irekzielinski/Pylontech-Battery-Monitoring/(threads)

Thread 1 (2019-10-15):

Response is only ????

TMHEINE, 2019-10-15:
Hi,
I did all the same as you did, with the same elements (Wemos D1 mini, Sparkfun Max3232).
I can access the web interface. But all responses I get is always "????".
What is wrong?
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

djsyl, 2019-12-05:
hello
same thing for me !

TMHEINE, 2019-12-09:
I use now the can Port to read the SOC.
RPI3 with PiCan2

djsyl, 2019-12-12:
Now it work for me
when use a other max3232 not work
with the same of description it's good now

TMHEINE, 2021-04-22:
Hello,

I tried it again all new.
Parts:
Wemos D1 Mini v3.0.0
Sparkfun Max3232 (Bought a new one

I get the same Questionsmarks as before

Mainpage:
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
Power response:
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
The log is:
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

What could be the Problem? Wireing? Arduino?

Compiling Result Arduino:
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

Anyone who can help me?

irekzielinski, 2021-08-05:
@TMHEINE did you get it working?
Your log indicates that ESP is not establising any connection with the battery.
I suspect this is electrical issue/wiring.

TMHEINE, 2021-08-06:
Hello.
Didi not get it working. Electrical/wiring should not be the problem.
Maybe port is not working or something else.
I did not try it again after last test.
For the last test I used a new ESP and new Sparkfun.
I tried lot of different ways likt exchange RX and TX, Other capasitors, different power supplies.
but nothing worked.

So actually i am reading the batteries by can-hat and python.

Wibet10, 2022-02-12:
Hi,
I built one of these monitors a coupe of years ago and  it worked fine with my UC3000 batteries as described in the original design using the RJ11 port. End of last year I fited a new UC3000C battery as master and had to convert to the 8 pin 'Console' port. I rewired the cable and it started working but was erratic. It then refused to read at all and I abandonned it until this month. On investigation, the RS232 signals were barely 8-10volts pk/pk and the MQTT was trying to reconnect every cycle of the program. I also discovered from the web that the UC2000/3000C batteries do not need the 1200/115200 codes and  rate change to wake them, they are ready to communicate at 115200 on startup.
I have commented out 'void wakeUpConsole and void switchBaud' sections of the code and added this into the void loop: -
   void loop() {
  // millis delay check below runs 'mqttLoop' every 30 seconds
      Client.loop();
        if (millis() - lastMillis >= 30*1000UL) // >= 30 sec period
    {
     lastMillis = millis();  // reset ready for next loop
        mqttLoop();
    }
   ArduinoOTA.handle();
  server.handleClient();
  timer.run();_
code from this point is original --
The erratic connection problem was fixed by including a level shifter between the ESP and the MAX3232 as in the attached diagram.
This had the effect of increasing the RS232 signal voltages sent to the battery to around 12/15volts pk/pk, much more in spec and very solid connection.
There seems to have been some changes that accomodate the new battry types since I last checked in (November 2021) and reading the above comments, the discoveries I made in adapting my original build may help resove some of the problems experienced by others.
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
Hope this helps others connecting to UC2000/3000C batteries.

irekzielinski, 2022-02-12:
Thanks - that some good findings!
Do you really need to wrap mqttLoop(); into this 1in30 seconds condition?
There should be no problem calling this every time loop is executed.

Wibet10, 2022-02-12:
Hi, Thanks for the response. I hope the info. on getting a better RS232 connection helps others.
In my original build I tried several MAX3232's before I found a working one. On testing the voltages on my worker during the upgrade, @3.3v the o/p is minimum spec, @5v it is comfortably in spec.
My coding is 'cut and paste' at best! My original problem was the mqtt disconnecting/reconnecting on every loop. In tracing this back to my mqtt user/password set-up, I broke your mqttloop code (probably the syntax somewhere). My crude fix was to put the timing loop into the main loop and only run the mqttloop every 30 secs. My code now compiles and runs ok, think I'll leave it running for a while and look at fixing it later.
Thanks for a great project that has kept up with the battery developments, cheaper than setting up Batteryview and almost as good, nice one!

Wibet10, 2022-02-16:
Sorry you are still having proiblems. I have mine running using the enclosed code, it compiles using Arduino IDE 1.8.13 & 2.0.0rc3 on a Win10 PC. I have a genuine Wemos Mini Pro and a 'cheap generic' Max3232. I started out in February with no reads from the Pylon-stack (Master is now UC3000C - new type) and only ??? when I accessed the local 192.168.1.71 site.
I 'fiddled about' with the code and put in a 'lot of debug comments' to get my head around how it worked, I did get it going but I think I broke some of the original code? My changes are around lines 745-798 and 848-870 in the attached version. There are a lot of serial.prints/notes I have put in to help me remember what I did, hope it helps you sort yours.
DON'T leave any 'extra' Serial.prints in the code or IT WILL totally disrupt the reading of the Pylontech's.
(this is the code as it is working for me now -  copy + paste it into Arduino IDE)
All credit goes to Irek for his original code.

// WiFi code for 'D1 mini Pro' to run Pylontech Console Port into Node Red server on 192.168.1.197
// Has pylontech battery web server access @ 192.168.1.71 (local wifi port)
// Updated 07-02-2022 Taking out start at 1200 and handshake to then switch to 115200 (older batteries) - now starts at 115200 and just reads.

#include <ESP8266WiFi.h>
#include <ESP8266mDNS.h>
#include <ArduinoOTA.h>
#include <ESP8266WebServer.h>
#include <PubSubClient.h>
#include <SimpleTimer.h>
#include <TimeLib.h>        //https://github.com/PaulStoffregen/Time
#include <ntp_time.h>       // this library needs loading manually
#include <circular_log.h>   // this library needs loading manually

//#define DEBUG  // Comment out to remove DEBUG Serial prints - useful to see the loops running
                // if left enabled while connected to pylon - it WILL corrupt the real pylon data reads!!

//IMPORTANT: Specify your WIFI settings:
#define WIFI_SSID "xxxxxxxxxxxxxxxxx"
#define WIFI_PASS "xxxxxxxxxxxxxx"

//IMPORTANT: Uncomment this line if you want to enable MQTT (and fill correct MQTT_ values below):
#define ENABLE_MQTT

#ifdef ENABLE_MQTT
//NOTE 1: if you want to change what is pushed via MQTT - edit function: pushBatteryDataToMqtt. (line 822)
//NOTE 2: MQTT_TOPIC_ROOT is where battery will push MQTT topics. For example "soc" will be pushed to: "pylon_battery/soc"
//Note 3: Using WiFi into Raspberry Pi
#define MQTT_SERVER        "192.168.1.197"  //is Node Red Home Server IP {Home mqtt server 127.0.0.1:1883}
#define MQTT_PORT          1883
#define MQTT_USER          "emonpi"
#define MQTT_PASSWORD      "xxxxxxxxxxxxxx"
#define MQTT_TOPIC_ROOT    "emon/pylon_battery/"  //this is where mqtt data will be pushed
//#define MQTT_PUSH_FREQ_SEC 30  // MQTT push now set by millis delay in 'void loop'
#endif //for #def ENABLE_MQTT

#define ABS_DIFF(a, b) (a > b ? a-b : b-a)

WiFiClient batClient;
PubSubClient Client(batClient);  // set-up MQTT client

char g_szRecvBuff[7000];
static unsigned long g_lastDataSent = 0; //sets initial MQTT last-sent time for first loop
unsigned long lastMillis;

ESP8266WebServer server(80);
SimpleTimer timer;
circular_log<7000> g_log;
bool ntpTimeReceived = false;
int g_baudRate = 0;

void Log(const char* msg)
{
  g_log.Log(msg);
  #ifdef DEBUG
  Serial.println("logging messages");
  #endif
}
//  'callback' Not needed for Pylon??
void callback(char* topic, byte* payload, unsigned int length) {
  Serial.print("Message arrived [");
  Serial.print(topic);
  Serial.print("] ");
  for (int i = 0; i < length; i++) {
    Serial.print((char)payload[i]);
  }
  Serial.println();
}

void reconnect() {
  // loop until we are reconnected
  while (!Client.connected()) {
    Serial.println("Attempting MQTT connection...");
    // Attempt to connect ..
    if (Client.connect("batClient", MQTT_USER, MQTT_PASSWORD ))  {
      Serial.println("connected to MQTT....");
    } else{
      Serial.print("failed. rc= ");
      Serial.println(Client.state());
      Serial.println("Try again in 5 seconds ...");
      delay(5000);
     }
  }
}

void setup_wifi(){
 // We start by connecting to a WiFi network
  WiFi.begin(WIFI_SSID, WIFI_PASS);
  while (WiFi.status() != WL_CONNECTED) {
    delay(500);
    Serial.print(".");
  }
  Serial.println("");
  Serial.println("WiFi connected");
}

void setup() {
   // put your setup code here, to run once:
   Serial.begin(115200);  // new line to start serial at 115200
   #ifdef DEBUG
   Serial.println (".");
   Serial.println ("Set Serial to 115200");
   #endif
    delay(200);
  setup_wifi();
  delay(200);
  #ifdef DEBUG
  Serial.println ("Setting up MQTT server in SETUP ~~~~~~~~~");
  #endif
    Client.setServer(MQTT_SERVER, MQTT_PORT);
    Client.setCallback(callback);    // callback not needed for pylon??

    while (!Client.connected()){
  Serial.println();
  Serial.print("Connecting to ");
  Serial.println(MQTT_SERVER);
  if (Client.connect("batClient", MQTT_USER, MQTT_PASSWORD )) {
    Serial.println(" Connected to MQTT ...");
  } else {
    Serial.print("failed to connect to MQTT with state  ");
    Serial.print(Client.state());
    delay(2000);
      }
    }
  #ifdef DEBUG
  Serial.println("Connected to MQTT .. in setup");
  #endif

  pinMode(LED_BUILTIN, OUTPUT);
  digitalWrite(LED_BUILTIN, HIGH);//high is off

  ArduinoOTA.setHostname("Home_Battery");
  ArduinoOTA.begin();
  server.on("/", handleRoot);
  server.on("/log", handleLog);
  server.on("/req", handleReq);
  server.on("/jsonOut", handleJsonOut);
  server.on("/reboot", [](){
    ESP.restart();
  });

  server.begin();

  syncTime();

  Log("Boot event");
}

void handleLog()
{
  server.send(200, "text/html", g_log.c_str());
}
 /*    This section commented out as old protocol to switch 1200 to 115200 baud
void switchBaud(int newRate)
{
  if(g_baudRate == newRate)
  {
    return;
  }

  if(g_baudRate != 0)
  {
    Serial.flush();
    delay(20);
    Serial.end();
    delay(20);
  }

  char szMsg[50];
  snprintf(szMsg, sizeof(szMsg)-1, "New baud: %d", newRate);
  Log(szMsg);

  Serial.begin(newRate);
  g_baudRate = newRate;
  #ifdef DEBUG
  Serial.println("End of switchBaud loop");
  #endif
  delay(20);
} */

void waitForSerial()
{
  for(int ix=0; ix<150;ix++)
  {
    if(Serial.available()) break;
    delay(10);
  }
  #ifdef DEBUG
  Serial.println("Waiting for serial");
  #endif
}

int readFromSerial()
{
  #ifdef DEBUG
  Serial.println("Starting int-readFromSerial()");
  #endif
  memset(g_szRecvBuff, 0, sizeof(g_szRecvBuff));
  int recvBuffLen = 0;
  bool foundTerminator = true;

  #ifdef DEBUG
  Serial.println("Terminator TRUE");  //#############found true return####################
  #endif

  waitForSerial();

  while(Serial.available())
    {
      #ifdef DEBUG
        Serial.println ("Serial is available");
      #endif

    char szResponse[256] = "";
    const int readNow = Serial.readBytesUntil('>', szResponse, sizeof(szResponse)-1); //all commands terminate with "$$\r\n\rpylon>" (no new line at the end)

    if(readNow > 0 &&
       szResponse[0] != '\0')
    {
      if(readNow + recvBuffLen + 1 >= (int)(sizeof(g_szRecvBuff)))
      {
        Log("WARNING: Read too much data on the console!");
        break;
      }

      strcat(g_szRecvBuff, szResponse);
      recvBuffLen += readNow;

      if(strstr(g_szRecvBuff, "$$\r\n\rpylon"))
      {
        strcat(g_szRecvBuff, ">"); //readBytesUntil will skip this, so re-add
        foundTerminator = true;
        break; //found end of the string
      }

      if(strstr(g_szRecvBuff, "Press [Enter] to be continued,other key to exit"))
      {
        //we need to send new line character so battery continues the output
        Serial.write("\r");
      }

      waitForSerial();
    }
  }

  if(recvBuffLen > 0 )
  {
    if(foundTerminator == false)
    {
      Log("Failed to find pylon> terminator");
    }
  }

  return recvBuffLen;
}

bool readFromSerialAndSendResponse()
{
  const int recvBuffLen = readFromSerial();
  if(recvBuffLen > 0)
  {
    server.sendContent(g_szRecvBuff);
    return true;
  }

  return false;
}

bool sendCommandAndReadSerialResponse(const char* pszCommand)
{
  //switchBaud(115200);  Comented out as do not needed to switch serial for 2000/3000C batteries

  if(pszCommand[0] != '\0')
  {
    Serial.write(pszCommand);
  }
  Serial.write("\n");

  const int recvBuffLen = readFromSerial();
  if(recvBuffLen > 0)
  {
    return true;

    #ifdef DEBUG
    Serial.println("Send Command and Receive Response = True");
    #endif
  }

  //wake up console and try again:
 // wakeUpConsole();  Commented out not needed

  if(pszCommand[0] != '\0')
  {
    Serial.write(pszCommand);
  }
  Serial.write("\n");

  return readFromSerial() > 0;
}

void handleReq()
{
  #ifdef DEBUG
  Serial.println("starting void-handleReq()");
  #endif
  bool respOK;
  if(server.hasArg("code") == false)
  {
    respOK = sendCommandAndReadSerialResponse("");
  }
  else
  {
    respOK = sendCommandAndReadSerialResponse(server.arg("code").c_str());
  }

  if(respOK)
  {
    server.send(200, "text/plain", g_szRecvBuff);
  }
  else
  {
    server.send(500, "text/plain", "????");
  }
}

void handleJsonOut()
{
  #ifdef DEBUG
  Serial.println("Starting void-handleJsonOut");
  #endif
  if(sendCommandAndReadSerialResponse("pwr") == false)
  {
    server.send(500, "text/plain", "Failed to get response to 'pwr' command");
    return;

  }
  parsePwrResponse(g_szRecvBuff);
  prepareJsonOutput(g_szRecvBuff, sizeof(g_szRecvBuff));
  server.send(200, "application/json", g_szRecvBuff);
}

void handleRoot() {
  #ifdef DEBUG
  Serial.println("Starting void-handleRoot");
  #endif
  unsigned long days = 0, hours = 0, minutes = 0;
  unsigned long val = os_getCurrentTimeSec();

  days = val / (3600*24);
  val -= days * (3600*24);

  hours = val / 3600;
  val -= hours * 3600;

  minutes = val / 60;
  val -= minutes*60;

  static char szTmp[2500] = "";
  snprintf(szTmp, sizeof(szTmp)-1, "<html><b>Home_Battery</b><br>Time GMT: %d/%02d/%02d %02d:%02d:%02d (%s)<br>Uptime: %02d:%02d:%02d.%02d<br><br>free heap: %u<br>Wifi RSSI: %d<BR>Wifi SSID: %s",
            year(), month(), day(), hour(), minute(), second(), "GMT",
            (int)days, (int)hours, (int)minutes, (int)val,
            ESP.getFreeHeap(), WiFi.RSSI(), WiFi.SSID().c_str());

  strncat(szTmp, "<BR><a href='/log'>Runtime log</a><HR>", sizeof(szTmp)-1);
  strncat(szTmp, "<form action='/req' method='get'>Command:<input type='text' name='code'/><input type='submit'></form><a href='/req?code=pwr'>Power</a> | <a href='/req?code=help'>Help</a> | <a href='/req?code=log'>Event Log</a> | <a href='/req?code=time'>Time</a>", sizeof(szTmp)-1);
  strncat(szTmp, "</html>", sizeof(szTmp)-1);

  server.send(200, "text/html", szTmp);
}

unsigned long os_getCurrentTimeSec()
{
  static unsigned int wrapCnt = 0;
  static unsigned long lastVal = 0;
  unsigned long currentVal = millis();

  if(currentVal < lastVal)
  {
    wrapCnt++;
  }

  lastVal = currentVal;
  unsigned long seconds = currentVal/1000;

  //millis will wrap each 50 days, as we are interested only in seconds, let's keep the wrap counter
  return (wrapCnt*4294967) + seconds;
}

void syncTime()
{
  //get time from NTP
  time_t currentTimeGMT = getNtpTime();
  if(currentTimeGMT)
  {
    ntpTimeReceived = true;
    setTime(currentTimeGMT);
    #ifdef DEBUG
    Serial.println("NTP Time Synced OK");
    #endif
  }
  else
  {
    timer.setTimeout(5000, syncTime); //try again in 5 seconds
  }
}
/* This section commented out not needed for 2000/3000C batteries
void wakeUpConsole()
{
  switchBaud(1200);

  //byte wakeUpBuff[] = {0x7E, 0x32, 0x30, 0x30, 0x31, 0x34, 0x36, 0x38, 0x32, 0x43, 0x30, 0x30, 0x34, 0x38, 0x35, 0x32, 0x30, 0x46, 0x43, 0x43, 0x33, 0x0D};
  //Serial.write(wakeUpBuff, sizeof(wakeUpBuff));
  Serial.write("~20014682C0048520FCC3\r");
  delay(1000);

  byte newLineBuff[] = {0x0E, 0x0A};
  switchBaud(115200);

  for(int ix=0; ix<10; ix++)
  {
    Serial.write(newLineBuff, sizeof(newLineBuff));
    delay(1000);

    if(Serial.available())
    {
      while(Serial.available())
      {
        Serial.read();
      }

      break;
    }
  }
}  */

#define MAX_PYLON_BATTERIES 4  // was 8

struct pylonBattery
{
  bool isPresent;
  long  soc;     //Coulomb in %
  long  voltage; //in mW
  long  current; //in mA, negative value is discharge
  long  tempr;   //temp of case or BMS?
  long  cellTempLow;
  long  cellTempHigh;
  long  cellVoltLow;
  long  cellVoltHigh;
  char baseState[9];    //Charge | Dischg | Idle
  char voltageState[9]; //Normal
  char currentState[9]; //Normal
  char tempState[9];    //Normal
  char time[20];        //2019-06-08 04:00:29
  char b_v_st[9];       //Normal  (battery voltage?)
  char b_t_st[9];       //Normal  (battery temperature?)

  bool isCharging()    const { return strcmp(baseState, "Charge")   == 0; }
  bool isDischarging() const { return strcmp(baseState, "Dischg")   == 0; }
  bool isIdle()        const { return strcmp(baseState, "Idle")     == 0; }
  bool isBalancing()   const { return strcmp(baseState, "Balance")  == 0; }

  bool isNormal() const
  {
    if(isCharging()    == false &&
       isDischarging() == false &&
       isIdle()        == false &&
       isBalancing()   == false)
    {
      return false; //base state looks wrong!
    }

    return  strcmp(voltageState, "Normal") == 0 &&
            strcmp(currentState, "Normal") == 0 &&
            strcmp(tempState,    "Normal") == 0 &&
            strcmp(b_v_st,       "Normal") == 0 &&
            strcmp(b_t_st,       "Normal") == 0 ;
  }
};

struct batteryStack
{
  int batteryCount;
  int soc;  //in %, if charging: average SOC, otherwise: lowest SOC
  int temp; //in mC, if highest temp is > 15C, this will show the highest temp, otherwise the lowest
  long currentDC;    //mAh current going in or out of the battery
  long avgVoltage;    //in mV
  char baseState[10];  //Charge | Dischg | Idle | Balance | Alarm!

  pylonBattery batts[MAX_PYLON_BATTERIES];

  bool isNormal() const
  {
    for(int ix=0; ix<MAX_PYLON_BATTERIES; ix++)
    {
      if(batts[ix].isPresent &&
         batts[ix].isNormal() == false)
      {
        return false;
      }
    }

    return true;
  }

  //in wH
  long getPowerDC() const
  {
    return (long)(((double)currentDC/1000.0)*((double)avgVoltage/1000.0));
  }

  //wH estimated current on AC side (taking into account Sofar ME3000SP losses)
  long getEstPowerAc() const
  {
    double powerDC = (double)getPowerDC();
    if(powerDC == 0)
    {
      return 0;
    }
    else if(powerDC < 0)
    {
      //we are discharging, on AC side we will see less power due to losses
      if(powerDC < -1000)
      {
        return (long)(powerDC*0.94);
      }
      else if(powerDC < -600)
      {
        return (long)(powerDC*0.90);
      }
      else
      {
        return (long)(powerDC*0.87);
      }
    }
    else
    {
      //we are charging, on AC side we will have more power due to losses
      if(powerDC > 1000)
      {
        return (long)(powerDC*1.06);
      }
      else if(powerDC > 600)
      {
        return (long)(powerDC*1.1);
      }
      else
      {
        return (long)(powerDC*1.13);
      }
    }
  }
};

batteryStack g_stack;

long extractInt(const char* pStr, int pos)
{
  return atol(pStr+pos);
}

void extractStr(const char* pStr, int pos, char* strOut, int strOutSize)
{
  strOut[strOutSize-1] = '\0';
  strncpy(strOut, pStr+pos, strOutSize-1);
  strOutSize--;

  //trim right
  while(strOutSize > 0)
  {
    if(isspace(strOut[strOutSize-1]))
    {
      strOut[strOutSize-1] = '\0';
    }
    else
    {
      break;
    }

    strOutSize--;
  }
}

/* Output has mixed \r and \r\n
pwr

@

Power Volt   Curr   Tempr  Tlow   Thigh  Vlow   Vhigh  Base.St  Volt.St  Curr.St  Temp.St  Coulomb  Time                 B.V.St   B.T.St

1     49735  -1440  22000  19000  19000  3315   3317   Dischg   Normal   Normal   Normal   93%      2019-06-08 04:00:30  Normal   Normal

....

8     -      -      -      -      -      -      -      Absent   -        -        -        -        -                    -        -

Command completed successfully

$$

pylon
*/
bool parsePwrResponse(const char* pStr)
{
    if(strstr(pStr, "Command completed successfully") == NULL)
  {
    return false;
  }

  int chargeCnt    = 0;
  int dischargeCnt = 0;
  int idleCnt      = 0;
  int alarmCnt     = 0;
  int socAvg       = 0;
  int socLow       = 0;
  int tempHigh     = 0;
  int tempLow      = 0;

  memset(&g_stack, 0, sizeof(g_stack));

  for(int ix=0; ix<MAX_PYLON_BATTERIES; ix++)
  {
    char szToFind[32] = "";
    snprintf(szToFind, sizeof(szToFind)-1, "\r\r\n%d     ", ix+1);

    const char* pLineStart = strstr(pStr, szToFind);
    if(pLineStart == NULL)
    {
      return false;
    }

    pLineStart += 3; //move past \r\r\n

    extractStr(pLineStart, 55, g_stack.batts[ix].baseState, sizeof(g_stack.batts[ix].baseState));
    if(strcmp(g_stack.batts[ix].baseState, "Absent") == 0)
    {
      g_stack.batts[ix].isPresent = false;
    }
    else
    {
      g_stack.batts[ix].isPresent = true;
      extractStr(pLineStart, 64, g_stack.batts[ix].voltageState, sizeof(g_stack.batts[ix].voltageState));
      extractStr(pLineStart, 73, g_stack.batts[ix].currentState, sizeof(g_stack.batts[ix].currentState));
      extractStr(pLineStart, 82, g_stack.batts[ix].tempState, sizeof(g_stack.batts[ix].tempState));
      extractStr(pLineStart, 100, g_stack.batts[ix].time, sizeof(g_stack.batts[ix].time));
      extractStr(pLineStart, 121, g_stack.batts[ix].b_v_st, sizeof(g_stack.batts[ix].b_v_st));
      extractStr(pLineStart, 130, g_stack.batts[ix].b_t_st, sizeof(g_stack.batts[ix].b_t_st));
      g_stack.batts[ix].voltage = extractInt(pLineStart, 6);
      g_stack.batts[ix].current = extractInt(pLineStart, 13);
      g_stack.batts[ix].tempr   = extractInt(pLineStart, 20);
      g_stack.batts[ix].cellTempLow    = extractInt(pLineStart, 27);
      g_stack.batts[ix].cellTempHigh   = extractInt(pLineStart, 34);
      g_stack.batts[ix].cellVoltLow    = extractInt(pLineStart, 41);
      g_stack.batts[ix].cellVoltHigh   = extractInt(pLineStart, 48);
      g_stack.batts[ix].soc            = extractInt(pLineStart, 91);

      //////////////////////////////// Post-process ////////////////////////
      g_stack.batteryCount++;
      g_stack.currentDC += g_stack.batts[ix].current;
      g_stack.avgVoltage += g_stack.batts[ix].voltage;
      socAvg += g_stack.batts[ix].soc;

      if(g_stack.batts[ix].isNormal() == false){ alarmCnt++; }
      else if(g_stack.batts[ix].isCharging()){chargeCnt++;}
      else if(g_stack.batts[ix].isDischarging()){dischargeCnt++;}
      else if(g_stack.batts[ix].isIdle()){idleCnt++;}
      else{ alarmCnt++; } //should not really happen!

      if(g_stack.batteryCount == 1)
      {
        socLow = g_stack.batts[ix].soc;
        tempLow  = g_stack.batts[ix].cellTempLow;
        tempHigh = g_stack.batts[ix].cellTempHigh;
      }
      else
      {
        if(socLow > g_stack.batts[ix].soc){socLow = g_stack.batts[ix].soc;}
        if(tempHigh < g_stack.batts[ix].cellTempHigh){tempHigh = g_stack.batts[ix].cellTempHigh;}
        if(tempLow > g_stack.batts[ix].cellTempLow){tempLow = g_stack.batts[ix].cellTempLow;}
      }

    }
  }

  //now update stack state:

  g_stack.avgVoltage /= g_stack.batteryCount;
  g_stack.soc = socLow;

  if(tempHigh > 15000) //15C
  {
    g_stack.temp = tempHigh; //in the summer we highlight the warmest cell
  }
  else
  {
    g_stack.temp = tempLow; //in the winter we focus on coldest cell
  }

  if(alarmCnt > 0)
  {
    strcpy(g_stack.baseState, "Alarm");
  }
  else if(chargeCnt == g_stack.batteryCount)
  {
    strcpy(g_stack.baseState, "Charge");
    g_stack.soc = (int)(socAvg / g_stack.batteryCount);
  }
  else if(dischargeCnt == g_stack.batteryCount)
  {
    strcpy(g_stack.baseState, "Discharge");
  }
  else if(idleCnt == g_stack.batteryCount)
  {
    strcpy(g_stack.baseState, "Idle");
  }
  else
  {
    strcpy(g_stack.baseState, "Balance");
  }

  return true;
}

void prepareJsonOutput(char* pBuff, int buffSize)
{
  #ifdef DEBUG
  Serial.println("starting void-prepareJsonOutput");
  #endif
  memset(pBuff, 0, buffSize);
  snprintf(pBuff, buffSize-1, "{\"soc\": %d, \"temp\": %d, \"currentDC\": %ld, \"avgVoltage\": %ld, \"baseState\": \"%s\", \"batteryCount\": %d, \"powerDC\": %ld, \"estPowerAC\": %ld, \"isNormal\": %s}", g_stack.soc,
                                                                                                                                                                                                            g_stack.temp,
                                                                                                                                                                                                            g_stack.currentDC,
                                                                                                                                                                                                            g_stack.avgVoltage,
                                                                                                                                                                                                            g_stack.baseState,
                                                                                                                                                                                                            g_stack.batteryCount,
                                                                                                                                                                                                            g_stack.getPowerDC(),
                                                                                                                                                                                                            g_stack.getEstPowerAc(),
                                                                                                                                                                                                            g_stack.isNormal() ? "true" : "false");
}

void loop() {
  // millis delay check below runns mqttLoop every 30 seconds
    #ifdef DEBUG
    Serial.println("starting void-loop()");
    #endif
  Client.loop();
    #ifdef DEBUG
    Serial.println("completed client.loop ~~~~~~~~~~~~~~~~~");
    #endif
     if (millis() - lastMillis >= 30*1000UL) // >= 30 sec period
    {
       // Serial.println("completed MQTT delay check ~~~~~~~~~~~~~~~~~");

    lastMillis = millis();  // reset ready for next loop
    mqttLoop();
    }

  ArduinoOTA.handle();
  server.handleClient();
  timer.run();

  //if there are bytes availbe on serial here - it's unexpected
  //when we send a command to battery, we read whole response
  //if we get anything here anyways - we will log it

  int bytesAv = Serial.available();
  if(bytesAv > 0)
  {
    if(bytesAv > 63)
    {
      bytesAv = 63;
    }

    char buff[64+4] = "RCV:";
    if(Serial.readBytes(buff+4, bytesAv) > 0)
    {
           Log(buff);
       #ifdef DEBUG
           Serial.println("Logging Buffer -  void-loop");
       #endif
    }
  }
      #ifdef DEBUG
       Serial.println("void-loop flash led");
      #endif
      digitalWrite(LED_BUILTIN, LOW);
      delay(50);
      digitalWrite(LED_BUILTIN, HIGH);//high is off

  #ifdef DEBUG
  Serial.println("END of void-loop");
  #endif

}

// #define ABS_DIFF(a, b) (a > b ? a-b : b-a)

void mqtt_publish_f(const char* topic, float newValue, float oldValue, float minDiff, bool force)
{
  char szTmp[16] = "";
  snprintf(szTmp, 15, "%.2f", newValue);
  if(force || ABS_DIFF(newValue, oldValue) > minDiff)
  {
    Client.publish(topic, szTmp, false);
  }
}

void mqtt_publish_i(const char* topic, int newValue, int oldValue,
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

Thread 3 (2020-02-06):

Sofar Inverter

timecmdr, 2020-02-06:
Hi Irek,

I notice you have the same Inverter as me., Do you get the data about the power usage at your home from the battery data or do you use some other method to get it from the SOFAR?

irekzielinski, 2020-02-16:
> I notice you have the same Inverter as me., Do you get the data about the power usage at your home from the battery data or do you use some other method to get it from the SOFAR?

Hi. Inverter has some kind of WiFi device (called iGen) and it has an API that I managed to communicate with, but can't decode the response. Older versions have been reverse engeneered (https://github.com/XtheOne/Inverter-Data-Logger) - but not this one. That was a reason for me to communicate with batteries directly.

To monitor house load/pv genertion I use "OWL Intuition-PV" device. It uses CT clamps and broadcases UDP packets on local lan with those details.

Closed 2021-08-05.

Thread 4 (2020-10-08):

error compile

mihaigsm2003, 2020-10-08:
Hi, i try compile to my ESP8266 but receive error

```
Arduino: 1.8.13 (Windows 7), Board: "LOLIN(WEMOS) D1 R2 & mini, 80 MHz, Flash, Legacy (new can return nullptr), All SSL ciphers (most compatible), 4MB (FS:2MB OTA:~1019KB), v2 Lower Memory, Disabled, None, Only Sketch, 921600"

C:\Users\user\Desktop\Pylontech-Battery-Monitoring-master\PylontechMonitoring\PylontechMonitoring.ino: In function 'void syncTime()':

PylontechMonitoring:310:11: error: 'class SimpleTimer' has no member named 'setTimeout'

     timer.setTimeout(5000, syncTime); //try again in 5 seconds

           ^

C:\Users\user\Desktop\Pylontech-Battery-Monitoring-master\PylontechMonitoring\PylontechMonitoring.ino: In function 'void loop()':

PylontechMonitoring:654:9: error: 'class SimpleTimer' has no member named 'run'

   timer.run();

         ^

Multiple libraries were found for "ArduinoOTA.h"

 Used: C:\Users\user\AppData\Local\Arduino15\packages\esp8266\hardware\esp8266\2.7.4\libraries\ArduinoOTA

 Not used: C:\Users\user\Documents\Arduino\libraries\ArduinoOTA

Multiple libraries were found for "SimpleTimer.h"

 Used: C:\Users\user\Documents\Arduino\libraries\SimpleTimer

 Not used: C:\Program Files (x86)\Arduino\libraries\Time-master

 Not used: C:\Program Files (x86)\Arduino\libraries\SimpleTimer

Multiple libraries were found for "TimeLib.h"

 Used: C:\Users\user\Documents\Arduino\libraries\Time

 Not used: C:\Program Files (x86)\Arduino\libraries\Time-master

exit status 1

'class SimpleTimer' has no member named 'setTimeout'

```
Any help?

mihaigsm2003, 2020-10-09:
Solved, deleted all installed arduino software from pc, then copiled (Used: C:\Users\user\AppData\Local\Arduino15....  need removed)

Closed 2020-11-11.

Thread 5 (2021-04-16):

US2000C and US3000C models.

JosekeyRandom, 2021-04-16:
Good morning, could you add communication with the new US2000C and US3000C models? Apparently an rj45 port is already used for console mode but something must have changed in the protocol because the only software that works is MultiSIBControl and it had to make a small update to recognize them http://www.multisibcontrol.net/

Would it be possible to add support for the new models?

Here is information about the connections https://powerforum.co.za/topic/7901-pylontech-us3000c/

Thanks.

Good morning, could you add communication with the new US2000C and US3000C models? Apparently an rj45 port is already used for console mode but something must have changed in the protocol because the only software that works is MultiSIBControl and it had to make a small update to recognize them http://www.multisibcontrol.net/

Would it be possible to add support for the new models?

Here is information about the connections https://powerforum.co.za/topic/7901-pylontech-us3000c/

Thanks.

PD: I still do not have any of these new models but they are probably the ones that will be sold when the stock of old models runs out.

mihaigsm2003, 2021-04-16:
Hi there!

I gest have ready partially software for esp8266 and I use to my server :

https://gsx.ro/d/RijerOxMz/casa-haotik?orgId=1&refresh=1m

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

irekzielinski, 2021-08-05:
Hi guys. I don't have a C model so can't experiment.
@mihaigsm2003 - which battery do you have? Is it a "C" model?
Can you share your wiring diagram and if you had to make any other changes (for example is the protocol the same)?

Thanks!
Irek

Tinbum1, 2021-08-10:
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

 Both are RJ45 sockets, not sure about the protocol.

dmqgit, 2021-12-16:
Everything works with the newer C-Series (hopefully still of interest). Protocol did not change. Just change to the socket to RJ45. Thanks @irekzielinski for the code.

mihaigsm2003, 2021-12-16:
i have pinout and work very good, but i need to read data from battery and place via mqtt in grafana. need to read each cell automatically at every 30 seconds

irekzielinski, 2021-12-16:
> Everything works with the newer C-Series (hopefully still of interest). Protocol did not change. Just change to the socket to RJ45. Thanks @irekzielinski for the code.

Thanks for the info - would you mind providing some deails of the wiring you used?
I will be happy to update the documentation.

dmqgit, 2021-12-16:
Sure.

RJ45 cable has 8 wires (outer right is full brown color based on EIA/TIA-568-B (version EIA/TIA-568-A is different)):

3 (white-green) = rx
6 (green) = tx
8 (brown) = gnd

irekzielinski, 2021-12-16:
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

Thanks. Just to be 100% sure:
> 3 (white-green) = rx
Is this RX of the battery (so should be connected to TX of Wemos), or the other way around?

dmqgit, 2021-12-16:
No, the other way around :)

3 (white-green) tx.pylontechtech = rx.wemos

irekzielinski, 2021-12-16:
> No, the other way around :)
>
> 3 (white-green) tx.pylontechtech = rx.wemos

Thanks, updated the front page with this information. And closing this issue as support it now confirmed :)

dmqgit, 2021-12-16:
Thank you.

mduchain, 2022-01-02:
Just a feedback; I have US2000B Plus manufactured September 2021 and it doesn't need the wakeup sequence to actually get the "pylon>" prompt. No need to drop to 1200 baud or send that byte sequence to communicate.
Newer battery firmware probably. Here are the FW versions reported by the battery "info" command:

Device address      : 1
Manufacturer        : Pylon
Device name         : US2KBPL
Board version       : PHANTOMSAV10R03
Main Soft version   : B67.10.0.1
Soft  version       : V3.0
Boot  version       : V2.2
Comm version        : V2.0
Release Date        : 21-06-07

Specification       : 48V/50AH
Cell Number         : 15
Max Dischg Curr     : -100000mA
Max Charge Curr     : 102000mA
EPONPort rate       : 1200
Console Port rate   : 115200

irekzielinski, 2022-01-02:
> Just a feedback; I have US2000B Plus manufactured September 2021 and it doesn't need the wakeup sequence to actually get the "pylon>" prompt. No need to drop to 1200 baud or send that byte sequence to communicate. Newer battery firmware probably.

Interesting, is the "wake up" sequence doing any problems on your system? Or does it work with it?

mduchain, 2022-01-02:
No, the wake up doesn’t do any harm. The code was working as intended with the wakeup sequence.

I noticed that when I reset the battery without restart of the ESP, I would get the pylon prompt immediately without going through the wakeup sequence.

I then removed the wakeup code altogether and everything kept working fine, even after multiple reboot/power-toggles of both ESP and battery.

The batteries’ console serial speed is not configurable and fixed at 115200 according to the manuals I received together with the battery.

I do get some noise (bad chars) when not sending commands for a while, but I believe this is due to the MAX3232 working at 3.3V (gathered from a few posts around the subject).

I avoid this by sending a few CR/LF before sending the actual command – an alternative wakeup sequence of sorts.

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

Closed 2021-12-16.

Thread 9 (2022-04-20):

only see "????" on "power" , "help" ... timezone setting?

a68k, 2022-04-20:
not sure what is wrong ...
I can see the page with the uptime (where can this be set to show correct time?)
but when opening "help" or "power" I wait some time and only see a page with "????"

a68k, 2022-04-22:
thanks for competent help

not

gerdluthe, 2022-05-19:
Check your wemos, i'd used an wemos mini pro and the communication with my pylontech ended as yours in an ????
so i'd used an wemos mini d1, maybe a clone one and with this one i can comminicate with my pylontechs

RomanSar779, 2023-06-11:
Hallo @a68k, konntest du dein Problem mit einen anderen ESP lösen? Hab auch nur ????

luftdieb, 2024-12-15:
Same problem on my side. Cheap Wemos D1 Mini won't work. Webinterface show startpage but wasn't able to show battery status. After using Wemos from Delivery (Amazon), it works directly. It costs me 4h troubleshooting.

Thread 10 (2022-04-21):

RS485 ?

a68k, 2022-04-21:
Can it also work with RS485?

I have a ROSEN SOLAR 10kWh powerwall and some say, has the same BMS inside.
But has no serial port...

a68k, 2022-05-11:
20 days later ... no reply.

speculatrix, 2022-05-12:
> 20 days later ... no reply.

I'd get a refund on the hugely expensive support contract you paid for?

a68k, 2022-05-12:
who are you?
what is that for an answer???
showing yourself how dumb you are?

did it help/solve in the issue?
[x] no

did it show competence?
[x] no

speculatrix, 2022-05-12:
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

Entitled much? Arrogant much? Rude much?

a68k, 2022-05-12:
ask yourself in the mirror

speculatrix, 2022-05-12:
> ask yourself in the mirror

You've made an astonishing contribution to humanity here on github
https://github.com/a68k?tab=repositories

Oh wait, you've done nothing, zero, zilch.

a68k, 2022-05-12:
oh you are such a smart guy muhahaa
you are drunk? on drug? or from nature an a.h?
Go on, show the world more of you

gerdluthe, 2022-05-19:
check google, there are many tutorials to communicate via 485 with the pylontechs, this program I think won't run with RS485. your comments above are not useful !!!

Thread 11 (2022-06-10):

Question using on wired lan instead of WiFi

Tinbum1, 2022-06-10:
Is their an easy way to modify the sketch to use this on and Arduino Uno with an Ethernet shield.

commander-bln, 2023-07-07:
I am using the script on an esp32 with 3 Paylontech US5000 Battery's, -> works fine, but i want it with Ethernet instead of WLAN (for better stable-faster connection)
is it possible to get the code to work with this pcb - Wesp32 from Silicognition LLC ???

Thread 12 (2022-09-23):

SparkFun MAX3232

ch-pk, 2022-09-23:
Hi.
Wanted to ask if the circuit only works with the SparkFun MAX3232 or also with other RS232-TTL converters.

gerdluthe, 2022-09-23:
Give it a try, there's an max3232 onboard the aliexpress one's

ch-pk, 2022-09-23:
I tried this one from Ali but get no data.

gerdluthe, 2022-09-23:
i'd used an blank max3232 without any problems, you'd checked all the wiring stuff? wifi connection is good?

ch-pk, 2022-09-23:
WIFI is ok because I can access the site. But there is no data coming from Pylontech. I will check everything again otherwise solder a new one.
It is US2000C version.

gerdluthe, 2022-09-23:
mine is the us2000c too. good luck

ch-pk, 2022-09-23:
Thanks. Will try again.

fourofspades, 2023-06-01:
I'm having trouble sourcing that boards. Everywhere out of stock and many months leadtime.

This board appears to have USB, so presumably some form of chip onboard?

Could I use this without the need for max232?

FREENOVE ESP8266 Development Board (Compatible with Arduino IDE), ESP-12S Onboard Wi-Fi, MicroPython C Code, Detailed Tutorial, Example Projects https://amzn.eu/d/6RC3Umo

commander-bln, 2023-06-05:
hi

first- you need a Max3232 for converting the serial2ttl for the console port of the pylontech
sec. you can use any esp8266 or better the esp32 with 4MB
if using only the chip you need a converter for programming, if it is a deleopment Board you have the converter on board and therfor is the USB plug.

I used a "DOIT ESP32 DevKit V1" from Amazon  with an Ardafriut MAX3232 an works fine on pylontech US5000 (2X)
if needed i can upload an Fritzing layout??

bartixmayo, 2023-10-17:
In other project I had to try 4 (four!) noname/cheap serial2ttl boards until I have got working one.

Rustimation, 2024-11-14:
Same thing here:
Treedix Mini RS232 auf TTL MAX3232 (Amazon) costs about a quarter of the SparkFun product. It works in general. However you have to unplug the board (at least the RX line) from the D1 Mini Microcontroller in order to be able to upload a sketch. The Sparkfun thing didn't have this problem.

Thread 13 (2022-09-26):

Cycle Count

albundy0815, 2022-09-26:
I guess it would be very helpful to get the "cylce counts" also availble via MQTT. It's in the command "stats" but it seems, that this value is not inside the MQTT function.
It would be great to get this function... Thanks

tomba0815, 2022-12-05:
Hello Ireneusz,
I also wanted to ask if you could also query the number of cycles.

tomba0815, 2022-12-05:
I thinks that's not so easy, at first you have to pull the correct values ....

tomba0815, 2022-12-06:
I'm currently using the not-so-elegant way to do this via a request. I query the website via iobroker, then I use RegEx to extract the number of cycles.
This works, but is not as convenient as with MQTT.

albundy0815, 2022-12-06:
I guess the easiest thing for all, would be to implement it directly, that it can be provided by MQTT. But... still no response from the developer and my scripting experience is more than little. ;(

commander-bln, 2023-02-06:
i have tried it with my new pylontech US5000, Sketch works fine, i have updated the scetch to use with ESP32 and the first change to get SOC in MQTT, it works

for SOC i can help...if wanted

tomasvida, 2023-02-22:
> i have tried it with my new pylontech US5000, Sketch works fine, i have updated the scetch to use with ESP32 and the first change to get SOC in MQTT, it works
>
> for SOC i can help...if wanted

Could I ask for a sample of the modified code? I have high voltage Pylontech battery, I need to modify the code, so I would appreciate some inspiration.

commander-bln, 2023-02-22:
hello tomasvida
can i send you my *.ino file diretly? or shoud i post it here??

albundy0815, 2023-02-22:
> hello tomasvida can i send you my *.ino file diretly? or shoud i post it here??

if you paste it here, the whole community would be able to access.

tomasvida, 2023-02-22:
> hello tomasvida can i send you my *.ino file diretly? or shoud i post it here??

If it is possible, please be said to be here so that the others in the community can be black experiences. It will help us very much, and thank you for your work and willingness!

commander-bln, 2023-02-22:
here is my *ino file works on esp32 on pylontechUS5000 on RS232 Port

`#include <WiFi.h>
#include <ESPmDNS.h>
#include <ArduinoOTA.h>
#include <WebServer.h>
#include <WebServer.h>
#include <SimpleTimer.h>
#include <TimeLib.h> //https://github.com/PaulStoffregen/Time
#include <ntp_time.h>
#include <circular_log.h>

//IMPORTANT: Specify your WIFI settings:

#define WIFI_SSID "YourSSID"
#define WIFI_PASS "YourPass"

//IMPORTANT: Uncomment this line if you want to enable MQTT (and fill correct MQTT_ values below):
#define ENABLE_MQTT

#ifdef ENABLE_MQTT
//NOTE 1: if you want to change what is pushed via MQTT - edit function: pushBatteryDataToMqtt.
//NOTE 2: MQTT_TOPIC_ROOT is where battery will push MQTT topics. For example "soc" will be pushed to: "home/grid_battery/soc"
#define MQTT_SERVER        "192.168.100.5"
#define MQTT_PORT          1883
#define MQTT_USER          "YourUser"
#define MQTT_PASSWORD      "YourUserPassword"
#define MQTT_TOPIC_ROOT    "Pylontech/US5000/"  //this is where mqtt data will be pushed
#define MQTT_PUSH_FREQ_SEC 2  //maximum mqtt update frequency in seconds

#include <PubSubClient.h>
WiFiClient espClient;
PubSubClient mqttClient(espClient);
#endif //ENABLE_MQTT

char g_szRecvBuff[7000];

WebServer server(5042); // Port for Webserver, for Standard take 80
SimpleTimer timer;
circular_log<7000> g_log;
bool ntpTimeReceived = false;
int g_baudRate = 0;

void Log(const char* msg)
{
  g_log.Log(msg);
}

void setup() {
  pinMode(LED_BUILTIN, OUTPUT);
  digitalWrite(LED_BUILTIN, HIGH);//high is off

  // put your setup code here, to run once:
  WiFi.mode(WIFI_STA);
  WiFi.persistent(false); //our credentialss are hardcoded, so we don't need ESP saving those each boot (will save on flash wear)
  WiFi.hostname("ESP32toPylontechBattery");
  WiFi.begin(WIFI_SSID, WIFI_PASS);

  for(int ix=0; ix<10; ix++)
  {
    if(WiFi.status() == WL_CONNECTED)
    {
      break;
    }

    delay(1000);
  }

  ArduinoOTA.setHostname("YourHostname");
  ArduinoOTA.begin();
  server.on("/", handleRoot);
  server.on("/log", handleLog);
  server.on("/req", handleReq);
  server.on("/jsonOut", handleJsonOut);
  server.on("/reboot", [](){
    ESP.restart();
  });

  server.begin();

  syncTime();

#ifdef ENABLE_MQTT
  mqttClient.setServer(MQTT_SERVER, MQTT_PORT);
#endif

  Log("Boot event");
}

void handleLog()
{
  server.send(200, "text/html", g_log.c_str());
}

void switchBaud(int newRate)
{
  if(g_baudRate == newRate)
  {
    return;
  }

  if(g_baudRate != 0)
  {
    Serial.flush();
    delay(20);
    Serial.end();
    delay(20);
  }

  char szMsg[50];
  snprintf(szMsg, sizeof(szMsg)-1, "New baud: %d", newRate);
  Log(szMsg);

  Serial.begin(newRate);
  g_baudRate = newRate;

  delay(20);
}

void waitForSerial()
{
  for(int ix=0; ix<150;ix++)
  {
    if(Serial.available()) break;
    delay(10);
  }
}

int readFromSerial()
{
  memset(g_szRecvBuff, 0, sizeof(g_szRecvBuff));
  int recvBuffLen = 0;
  bool foundTerminator = true;

  waitForSerial();

  while(Serial.available())
  {
    char szResponse[256] = "";
    const int readNow = Serial.readBytesUntil('>', szResponse, sizeof(szResponse)-1); //all commands terminate with "$$\r\n\rpylon>" (no new line at the end)
    if(readNow > 0 &&
       szResponse[0] != '\0')
    {
      if(readNow + recvBuffLen + 1 >= (int)(sizeof(g_szRecvBuff)))
      {
        Log("WARNING: Read too much data on the console!");
        break;
      }

      strcat(g_szRecvBuff, szResponse);
      recvBuffLen += readNow;

      if(strstr(g_szRecvBuff, "$$\r\n\rpylon"))
      {
        strcat(g_szRecvBuff, ">"); //readBytesUntil will skip this, so re-add
        foundTerminator = true;
        break; //found end of the string
      }

      if(strstr(g_szRecvBuff, "Press [Enter] to be continued,other key to exit"))
      {
        //we need to send new line character so battery continues the output
        Serial.write("\r");
      }

      waitForSerial();
    }
  }

  if(recvBuffLen > 0 )
  {
    if(foundTerminator == false)
    {
      Log("Failed to find pylon> terminator");
    }
  }

  return recvBuffLen;
}

bool readFromSerialAndSendResponse()
{
  const int recvBuffLen = readFromSerial();
  if(recvBuffLen > 0)
  {
    server.sendContent(g_szRecvBuff);
    return true;
  }

  return false;
}

bool sendCommandAndReadSerialResponse(const char* pszCommand)
{
  switchBaud(115200);

  if(pszCommand[0] != '\0')
  {
    Serial.write(pszCommand);
  }
  Serial.write("\n");

  const int recvBuffLen = readFromSerial();
  if(recvBuffLen > 0)
  {
    return true;
  }

  //wake up console and try again:
  wakeUpConsole();

  if(pszCommand[0] != '\0')
  {
    Serial.write(pszCommand);
  }
  Serial.write("\n");

  return readFromSerial() > 0;
}

void handleReq()
{
  bool respOK;
  if(server.hasArg("code") == false)
  {
    respOK = sendCommandAndReadSerialResponse("");
  }
  else
  {
    respOK = sendCommandAndReadSerialResponse(server.arg("code").c_str());
  }

  if(respOK)
  {
    server.send(200, "text/plain", g_szRecvBuff);
  }
  else
  {
    server.send(500, "text/plain", "????");
  }
}

void handleJsonOut()
{
  if(sendCommandAndReadSerialResponse("pwr") == false)
  {
    server.send(500, "text/plain", "Failed to get response to 'pwr' command");
    return;
  }

  parsePwrResponse(g_szRecvBuff);
  prepareJsonOutput(g_szRecvBuff, sizeof(g_szRecvBuff));
  server.send(200, "application/json", g_szRecvBuff);
}

void handleRoot() {
  unsigned long days = 0, hours = 0, minutes = 0;
  unsigned long val = os_getCurrentTimeSec();

  days = val / (3600*24);
  val -= days * (3600*24);

  hours = val / 3600;
  val -= hours * 3600;

  minutes = val / 60;
  val -= minutes*60;

  static char szTmp[2500] = "";
  snprintf(szTmp, sizeof(szTmp)-1, "<html><b>YourHostname</b><br>Time GMT: %d/%02d/%02d %02d:%02d:%02d (%s)<br>Uptime: %02d:%02d:%02d.%02d<br><br>free heap: %u<br>Wifi RSSI: %d<BR>Wifi SSID: %s",
            year(), month(), day(), hour(), minute(), second(), "GMT",
            (int)days, (int)hours, (int)minutes, (int)val,
            ESP.getFreeHeap(), WiFi.RSSI(), WiFi.SSID().c_str());

  strncat(szTmp, "<BR><a href='/log'>Runtime log</a><HR>", sizeof(szTmp)-1);
  strncat(szTmp, "<form action='/req' method='get'>Command:<input type='text' name='code'/><input type='submit'></form><a href='/req?code=pwr'>Power</a> | <a href='/req?code=help'>Help</a> | <a href='/req?code=log'>Event Log</a> | <a href='/req?code=time'>Time</a>", sizeof(szTmp)-1);
  strncat(szTmp, "</html>", sizeof(szTmp)-1);

  server.send(200, "text/html", szTmp);
}

unsigned long os_getCurrentTimeSec()
{
  static unsigned int wrapCnt = 0;
  static unsigned long lastVal = 0;
  unsigned long currentVal = millis();

  if(currentVal < lastVal)
  {
    wrapCnt++;
  }

  lastVal = currentVal;
  unsigned long seconds = currentVal/1000;

  //millis will wrap each 50 days, as we are interested only in seconds, let's keep the wrap counter
  return (wrapCnt*4294967) + seconds;
}

void syncTime()
{
  //get time from NTP
  time_t currentTimeGMT = getNtpTime();
  if(currentTimeGMT)
  {
    ntpTimeReceived = true;
    setTime(currentTimeGMT);
  }
  else
  {
    timer.setTimeout(5000, syncTime); //try again in 5 seconds
  }
}

void wakeUpConsole()
{
  switchBaud(1200);

  //byte wakeUpBuff[] = {0x7E, 0x32, 0x30, 0x30, 0x31, 0x34, 0x36, 0x38, 0x32, 0x43, 0x30, 0x30, 0x34, 0x38, 0x35, 0x32, 0x30, 0x46, 0x43, 0x43, 0x33, 0x0D};
  //Serial.write(wakeUpBuff, sizeof(wakeUpBuff));
  Serial.write("~20014682C0048520FCC3\r");
  delay(1000);

  byte newLineBuff[] = {0x0E, 0x0A};
  switchBaud(115200);

  for(int ix=0; ix<10; ix++)
  {
    Serial.write(newLineBuff, sizeof(newLineBuff));
    delay(1000);

    if(Serial.available())
    {
      while(Serial.available())
      {
        Serial.read();
      }

      break;
    }
  }
}

#define MAX_PYLON_BATTERIES 8

struct pylonBattery
{
  bool isPresent;
  long  soc;     //Coulomb in %
  long  voltage; //in mW
  long  current; //in mA, negative value is discharge
  long  tempr;   //temp of case or BMS?
  long  cellTempLow;
  long  cellTempHigh;
  long  cellVoltLow;
  long  cellVoltHigh;
  char baseState[9];    //Charge | Dischg | Idle
  char voltageState[9]; //Normal
  char currentState[9]; //Normal
  char tempState[9];    //Normal
  char time[20];        //2019-06-08 04:00:29
  char b_v_st[9];       //Normal  (battery voltage?)
  char b_t_st[9];       //Normal  (battery temperature?)

  bool isCharging()    const { return strcmp(baseState, "Charge")   == 0; }
  bool isDischarging() const { return strcmp(baseState, "Dischg")   == 0; }
  bool isIdle()        const { return strcmp(baseState, "Idle")     == 0; }
  bool isBalancing()   const { return strcmp(baseState, "Balance")  == 0; }

  bool isNormal() const
  {
    if(isCharging()    == false &&
       isDischarging() == false &&
       isIdle()        == false &&
       isBalancing()   == false)
    {
      return false; //base state looks wrong!
    }

    return  strcmp(voltageState, "Normal") == 0 &&
            strcmp(currentState, "Normal") == 0 &&
            strcmp(tempState,    "Normal") == 0 &&
            strcmp(b_v_st,       "Normal") == 0 &&
            strcmp(b_t_st,       "Normal") == 0 ;
  }
};

struct batteryStack
{
  int batteryCount;
  int soc;  //in %, if charging: average SOC, otherwise: lowest SOC
  int temp; //in mC, if highest temp is > 15C, this will show the highest temp, otherwise the lowest
  long currentDC;    //mAh current going in or out of the battery
  long avgVoltage;    //in mV
  char baseState[9];  //Charge | Dischg | Idle | Balance | Alarm!

  pylonBattery batts[MAX_PYLON_BATTERIES];

  bool isNormal() const
  {
    for(int ix=0; ix<MAX_PYLON_BATTERIES; ix++)
    {
      if(batts[ix].isPresent &&
         batts[ix].isNormal() == false)
      {
        return false;
      }
    }

    return true;
  }

  //in wH
  long getPowerDC() const
  {
    return (long)(((double)currentDC/1000.0)*((double)avgVoltage/1000.0));
  }

  //wH estimated current on AC side (taking into account Sofar ME3000SP losses)
  long getEstPowerAc() const
  {
    double powerDC = (double)getPowerDC();
    if(powerDC == 0)
    {
      return 0;
    }
    else if(powerDC < 0)
    {
      //we are discharging, on AC side we will see less power due to losses
      if(powerDC < -1000)
      {
        return (long)(powerDC*0.94);
      }
      else if(powerDC < -600)
      {
        return (long)(powerDC*0.90);
      }
      else
      {
        return (long)(powerDC*0.87);
      }
    }
    else
    {
      //we are charging, on AC side we will have more power due to losses
      if(powerDC > 1000)
      {
        return (long)(powerDC*1.06);
      }
      else if(powerDC > 600)
      {
        return (long)(powerDC*1.1);
      }
      else
      {
        return (long)(powerDC*1.13);
      }
    }
  }
};

batteryStack g_stack;

long extractInt(const char* pStr, int pos)
{
  return atol(pStr+pos);
}

void extractStr(const char* pStr, int pos, char* strOut, int strOutSize)
{
  strOut[strOutSize-1] = '\0';
  strncpy(strOut, pStr+pos, strOutSize-1);
  strOutSize--;

  //trim right
  while(strOutSize > 0)
  {
    if(isspace(strOut[strOutSize-1]))
    {
      strOut[strOutSize-1] = '\0';
    }
    else
    {
      break;
    }

    strOutSize--;
  }
}

/* Output has mixed \r and \r\n
pwr

@

Power Volt   Curr   Tempr  Tlow   Thigh  Vlow   Vhigh  Base.St  Volt.St  Curr.St  Temp.St  Coulomb  Time                 B.V.St   B.T.St

1     49735  -1440  22000  19000  19000  3315   3317   Dischg   Normal   Normal   Normal   93%      2019-06-08 04:00:30  Normal   Normal

....

8     -      -      -      -      -      -      -      Absent   -        -        -        -        -                    -        -

Command completed successfully

$$

pylon
*/
bool parsePwrResponse(const char* pStr)
{
  if(strstr(pStr, "Command completed successfully") == NULL)
  {
    return false;
  }

  int chargeCnt    = 0;
  int dischargeCnt = 0;
  int idleCnt      = 0;
  int alarmCnt     = 0;
  int socAvg       = 0;
  int socLow       = 0;
  int tempHigh     = 0;
  int tempLow      = 0;

  memset(&g_stack, 0, sizeof(g_stack));

  for(int ix=0; ix<MAX_PYLON_BATTERIES; ix++)
  {
    char szToFind[32] = "";
    snprintf(szToFind, sizeof(szToFind)-1, "\r\r\n%d     ", ix+1);

    const char* pLineStart = strstr(pStr, szToFind);
    if(pLineStart == NULL)
    {
      return false;
    }

    pLineStart += 3; //move past \r\r\n

    extractStr(pLineStart, 55, g_stack.batts[ix].baseState, sizeof(g_stack.batts[ix].baseState));
    if(strcmp(g_stack.batts[ix].baseState, "Absent") == 0)
    {
      g_stack.batts[ix].isPresent = false;
    }
    else
    {
      g_stack.batts[ix].isPresent = true;
      extractStr(pLineStart, 64, g_stack.batts[ix].voltageState, sizeof(g_stack.batts[ix].voltageState));
      extractStr(pLineStart, 73, g_stack.batts[ix].currentState, sizeof(g_stack.batts[ix].currentState));
      extractStr(pLineStart, 82, g_stack.batts[ix].tempState, sizeof(g_stack.batts[ix].tempState));
      extractStr(pLineStart, 100, g_stack.batts[ix].time, sizeof(g_stack.batts[ix].time));
      extractStr(pLineStart, 121, g_stack.batts[ix].b_v_st, sizeof(g_stack.batts[ix].b_v_st));
      extractStr(pLineStart, 130, g_stack.batts[ix].b_t_st, sizeof(g_stack.batts[ix].b_t_st));
      g_stack.batts[ix].voltage = extractInt(pLineStart, 6);
      g_stack.batts[ix].current = extractInt(pLineStart, 13);
      g_stack.batts[ix].tempr   = extractInt(pLineStart, 20);
      g_stack.batts[ix].cellTempLow    = extractInt(pLineStart, 27);
      g_stack.batts[ix].cellTempHigh   = extractInt(pLineStart, 34);
      g_stack.batts[ix].cellVoltLow    = extractInt(pLineStart, 41);
      g_stack.batts[ix].cellVoltHigh   = extractInt(pLineStart, 48);
      g_stack.batts[ix].soc            = extractInt(pLineStart, 91);

      //////////////////////////////// Post-process ////////////////////////
      g_stack.batteryCount++;
      g_stack.currentDC += g_stack.batts[ix].current;
      g_stack.avgVoltage += g_stack.batts[ix].voltage;
      socAvg += g_stack.batts[ix].soc;

      if(g_stack.batts[ix].isNormal() == false){ alarmCnt++; }
      else if(g_stack.batts[ix].isCharging()){chargeCnt++;}
      else if(g_stack.batts[ix].isDischarging()){dischargeCnt++;}
      else if(g_stack.batts[ix].isIdle()){idleCnt++;}
      else{ alarmCnt++; } //should not really happen!

      if(g_stack.batteryCount == 1)
      {
        socLow = g_stack.batts[ix].soc;
        tempLow  = g_stack.batts[ix].cellTempLow;
        tempHigh = g_stack.batts[ix].cellTempHigh;
      }
      else
      {
        if(socLow > g_stack.batts[ix].soc){socLow = g_stack.batts[ix].soc;}
        if(tempHigh < g_stack.batts[ix].cellTempHigh){tempHigh = g_stack.batts[ix].cellTempHigh;}
        if(tempLow > g_stack.batts[ix].cellTempLow){tempLow = g_stack.batts[ix].cellTempLow;}
      }

    }
  }

  //now update stack state:
  g_stack.avgVoltage /= g_stack.batteryCount;
  g_stack.soc = socLow;

  if(tempHigh > 15000) //15C
  {
    g_stack.temp = tempHigh; //in the summer we highlight the warmest cell
  }
  else
  {
    g_stack.temp = tempLow; //in the winter we focus on coldest cell
  }

  if(alarmCnt > 0)
  {
    strcpy(g_stack.baseState, "Alarm!");
  }
  else if(chargeCnt == g_stack.batteryCount)
  {
    //strcpy(g_stack.baseState, "Charge");
    strcpy(g_stack.baseState, "Laden"); // change for German
    g_stack.soc = (int)(socAvg / g_stack.batteryCount);
  }
  else if(dischargeCnt == g_stack.batteryCount)
  {
    //strcpy(g_stack.baseState, "Dischg");
    strcpy(g_stack.baseState, "Entladen"); // change for German
  }
  else if(idleCnt == g_stack.batteryCount)
  {
    //strcpy(g_stack.baseState, "Idle");
    strcpy(g_stack.baseState, "Leerlauf"); // change for German
  }
  else
  {
    //strcpy(g_stack.baseState, "Balance");
    strcpy(g_stack.baseState, "Ausbalancieren"); // change for German
  }

  return true;
}

void prepareJsonOutput(char* pBuff, int buffSize)
{
  memset(pBuff, 0, buffSize);
  snprintf(pBuff, buffSize-1, "{\"soc\": %d, \"temp\": %d, \"currentDC\": %ld, \"avgVoltage\": %ld, \"baseState\": \"%s\", \"batteryCount\": %d, \"powerDC\": %ld, \"estPowerAC\": %ld, \"isNormal\": %s}", g_stack.soc,
                                                                                                                                                                                                            g_stack.temp,
                                                                                                                                                                                                            g_stack.currentDC,
                                                                                                                                                                                                            g_stack.avgVoltage,
                                                                                                                                                                                                            g_stack.baseState,
                                                                                                                                                                                                            g_stack.batteryCount,
                                                                                                                                                                                                            g_stack.getPowerDC(),
                                                                                                                                                                                                            g_stack.getEstPowerAc(),
                                                                                                                                                                                                            g_stack.isNormal() ? "true" : "false");
}

void loop() {
#ifdef ENABLE_MQTT
  mqttLoop();
#endif

  ArduinoOTA.handle();
  server.handleClient();
  timer.run();

  //if there are bytes availbe on serial here - it's unexpected
  //when we send a command to battery, we read whole response
  //if we get anything here anyways - we will log it
  int bytesAv = Serial.available();
  if(bytesAv > 0)
  {
    if(bytesAv > 63)
    {
      bytesAv = 63;
    }

    char buff[64+4] = "RCV:";
    if(Serial.readBytes(buff+4, bytesAv) > 0)
    {
      digitalWrite(LED_BUILTIN, LOW);
      delay(5);
      digitalWrite(LED_BUILTIN, HIGH);//high is off

      Log(buff);
    }
  }
}

#ifdef ENABLE_MQTT
#define ABS_DIFF(a, b) (a > b ? a-b : b-a)
void mqtt_publish_f(const char* topic, float newValue, float oldValue, float minDiff, bool force)
{
  char szTmp[16] = "";
  snprintf(szTmp, 15, "%.2f", newValue);
  if(force || ABS_DIFF(newValue, oldValue) > minDiff)
  {
    mqttClient.publish(topic, szTmp, false);
  }
}

void mqtt_publish_i(const char* topic, int newValue, int oldValue, int minDiff, bool force)
{
  char szTmp[16] = "";
  snprintf(szTmp, 15, "%d", newValue);
  if(force || ABS_DIFF(newValue, oldValue) > minDiff)
  {
    mqttClient.publish(topic, szTmp, false);
  }
}

void mqtt_publish_s(const char* topic, const char* newValue, const char* oldValue, bool force)
{
  if(force || strcmp(newValue, oldValue) != 0)
  {
    mqttClient.publish(topic, newValue, false);
  }
}

void pushBatteryDataToMqtt(const batteryStack& lastSentData, bool forceUpdate /* if true - we will send all data regardless if it's the same */)
{
  mqtt_publish_f(MQTT_TOPIC_ROOT "soc",              g_stack.soc,                lastSentData.soc,                0, forceUpdate);
  mqtt_publish_f(MQTT_TOPIC_ROOT "Temperatur",(float)g_stack.temp/1000.0,        (float)lastSentData.temp/1000.0, 0, forceUpdate);
  mqtt_publish_f(MQTT_TOPIC_ROOT "Voltage",          g_stack.avgVoltage/1000.0,  lastSentData.avgVoltage/1000.0,  0, forceUpdate);
  mqtt_publish_f(MQTT_TOPIC_ROOT "Current",          g_stack.currentDC/1000.0,   lastSentData.currentDC/1000.0,   0, forceUpdate);
  mqtt_publish_i(MQTT_TOPIC_ROOT "PowerAC",          g_stack.getEstPowerAc(),    lastSentData.getEstPowerAc(),   10, forceUpdate);
  mqtt_publish_i(MQTT_TOPIC_ROOT "PowerDC",          g_stack.getPowerDC(),       lastSentData.getPowerDC(),      10, forceUpdate);
 // mqtt_publish_i(MQTT_TOPIC_ROOT "ZelleLow",         g_stack.cellVoltLow,        0,        0, forceUpdate);
 // mqtt_publish_i(MQTT_TOPIC_ROOT "ZelleHigh",        g_stack.cellVoltHigh,       0,        0, forceUpdate);
  mqtt_publish_i(MQTT_TOPIC_ROOT "AnzahlBatterien",  g_stack.batteryCount,       lastSentData.batteryCount,       0, forceUpdate);
  mqtt_publish_s(MQTT_TOPIC_ROOT "Zustand",          g_stack.baseState,          lastSentData.baseState            , forceUpdate);
  mqtt_publish_i(MQTT_TOPIC_ROOT "normal",           g_stack.isNormal() ? 1:0,   lastSentData.isNormal() ? 1:0,   0, forceUpdate);
}

void mqttLoop()
{
  //if we have problems with connecting to mqtt server, we will attempt to re-estabish connection each 1minute (not more than that)
  static unsigned long g_lastConnectionAttempt = 0;

  //first: let's make sure we are connected to mqtt
  const char* topicLastWill = MQTT_TOPIC_ROOT "Verbindung";
  if (!mqttClient.connected() && (g_lastConnectionAttempt == 0 || os_getCurrentTimeSec() - g_lastConnectionAttempt > 60)) {
    if(mqttClient.connect("ESP32toPylontech", MQTT_USER, MQTT_PASSWORD, topicLastWill, 1, true, "getrennt"))
    {
      Log("Connected to MQTT server: " MQTT_SERVER);
      mqttClient.publish(topicLastWill, "Verbunden", true);
    }
    else
    {
      Log("Failed to connect to MQTT server.");
    }

    g_lastConnectionAttempt = os_getCurrentTimeSec();
  }

  //next: read data from battery and send via MQTT (but only once per MQTT_PUSH_FREQ_SEC seconds)
  static unsigned long g_lastDataSent = 0;
  if(mqttClient.connected() &&
     os_getCurrentTimeSec() - g_lastDataSent > MQTT_PUSH_FREQ_SEC &&
     sendCommandAndReadSerialResponse("pwr") == true)
  {
    static batteryStack lastSentData; //this is the last state we sent to MQTT, used to prevent sending the same data over and over again
    static unsigned int callCnt = 0;

    parsePwrResponse(g_szRecvBuff);

    bool forceUpdate = (callCnt % 20 == 0); //push all the data every 20th call
    pushBatteryDataToMqtt(lastSentData, forceUpdate);

    callCnt++;
    g_lastDataSent = os_getCurrentTimeSec();
    memcpy(&lastSentData, &g_stack, sizeof(batteryStack));
  }

  mqttClient.loop();
}

#endif //ENABLE_MQTT`

i will try to get the "stat" Data also, but this will not be so easy as change a good code

commander-bln, 2023-02-22:
[PylontechMonitoring-ESP32.txt](https://github.com/irekzielinski/Pylontech-Battery-Monitoring/files/10807248/PylontechMonitoring-ESP32.txt)

i hope this is better

rickyrickuk, 2023-10-26:
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

Did you have any luck with the stat data? Also interested to get some of the info from this command such as Cycle times, LT Cnt, etc.
Thanks

commander-bln, 2023-10-27:
@rickyrickuk
sorry, not yet

i hope now in the darker time i have more time to try a little bit
i will post here when i find a good solution

rickyrickuk, 2023-10-27:
> @rickyrickuk sorry, not yet
>
> i hope now in the darker time i have more time to try a little bit i will post here when i find a good solution

Thanks for the reply.
I am having a look myself too to see if I can put something together :-)

One thing I noticed, is there is a parameter called _Status Cnt_ in the stat command results, wondered if this is the number of times the stat command has been run and if so, this would go very high if we keep sending the command to the battery.
Not sure if this will trigger anything in the event of a warranty claim?

commander-bln, 2023-10-27:
@rickyrickuk

stat shows 1st Batt
if have more then 1 then
stat 1 is the first
CYCLE Times     :      163
stat 2 is the second
CYCLE Times     :       92
stat 3 is the third
CYCLE Times     :       55
...my data over the net....

Status Cnt.     :      629  <- this is my first battery (started on 1/23)

one example snip for
stat 1

@
Device address           1
Data Items      :     1281
HisData Items   :     1793
Charge Cnt.     :        0
Discharge Cnt.  :        0
Charge Times    :    51098
Status Cnt.     :      629
Idle Times      :    61779
COC Times       :        0
COC2 Times      :        0
DOC Times       :        0
DOC2 Times      :        0
COCA Times      :        0
DOCA Times      :        0
SC Times        :        2
Bat OV Times    :        0
Bat HV Times    :      360
Bat LV Times    :        0
Bat UV Times    :        0
Bat SLP Times   :        0
Pwr OV Times    :       17
Pwr HV Times    :      779
Pwr LV Times    :        0
Pwr UV Times    :        0
Pwr SLP Times   :        0
COT Times       :        0
CUT Times       :        0
DOT Times       :        0
DUT Times       :        0
CHT Times       :        0
CLT Times       :        0
DHT Times       :        0
DLT Times       :        0
Shut Times      :        1
Reset Times     :       16
RV Times        :        0
Input OV Times  :        0
SOH Times       :        0
BMICERR Times   :        0
CYCLE Times     :      163
SOH             :       99
Pwr Percent     :       21
Pwr Coulomb     : 75424820
Dsg Cap         : 16364081
HT@0.5C Cnt     :        0
LT@0.5C Cnt     :        0
HT Cnt          :        0
LT Cnt          :        0
LV Cnt          :       82
LifeWarn Times  :        0
LifeAlarm Times :        0
Command completed successfully
$$
pylon>

rickyrickuk, 2023-10-27:
@commander-bln
Thanks for the outputs.
I tried a few stat messages over a period of an hour or so and the StatusCnt value seemed to reset to 0, maybe its a count per 1/2 hr or something?

Thread 14 (2022-10-22):

read cells voltage

mihaigsm2003, 2022-10-22:
I need to read voltage from each cell and send via mqtt, how to add to code?

commander-bln, 2023-02-06:
i also need the cells voltage, the scetch only use the "pwr" Data (works fine), what have to be change to also get all the data from "bat" ??

have anybody tried this ???

gitisgreat2023, 2024-11-12:
I implemented reading out the individual cell voltages and saving them to MQTT topics using Node Red.

Here's the code
`[
    {
        "id": "210ecc232aa515d1",
        "type": "tab",
        "label": "Pylontech",
        "disabled": false,
        "info": "",
        "env": []
    },
    {
        "id": "1a2b3c4d5e6f7g8h",
        "type": "http request",
        "z": "210ecc232aa515d1",
        "name": "Get Battery Data",
        "method": "GET",
        "ret": "txt",
        "paytoqs": "ignore",
        "url": "http://pylon.fritz.box/req?code=bat",
        "tls": "",
        "persist": false,
        "proxy": "",
        "insecureHTTPParser": false,
        "authType": "",
        "senderr": false,
        "headers": [],
        "x": 890,
        "y": 540,
        "wires": [
            [
                "2b3c4d5e6f7g8h9i"
            ]
        ]
    },
    {
        "id": "2b3c4d5e6f7g8h9i",
        "type": "function",
        "z": "210ecc232aa515d1",
        "name": "Process Battery Data",
        "func": "// Get the HTML input from the HTTP request\nlet htmlInput = msg.payload;\n\n// Use a regular expression to extract voltage values from the provided HTML\nlet voltageRegex = /\\d+\\s+(\\d+)\\s+-?\\d+\\s+\\d+\\s+\\w+\\s+\\w+\\s+\\w+\\s+\\w+\\s+\\d+%\\s+\\d+\\s+\\w+/g;\nlet voltages = [];\nlet labels = [];\nlet match;\n\n// Loop through all matches and extract the voltage (second column)\nlet index = 0;\nwhile ((match = voltageRegex.exec(htmlInput)) !== null) {\n    if (match[1] !== '-') { // Check if the voltage is not absent\n        voltages.push(parseInt(match[1]));\n        node.warn(\"C\" + (index + 1) +' '+voltages[index]+'mV')\n        labels.push('C' + (index + 1) + ' ' + voltages[index] + 'mV'); // Create labels for each cell\n        //labels.push(`C${index + 1}${voltages[index]}`); // Create labels for each cell\n        index++;\n    }\n}\n\n\n\n// Calculate the minimum and maximum voltages\nlet minVoltage = Math.min(...voltages);\nlet maxVoltage = Math.max(...voltages);\n\n// Calculate the average voltage\nlet averageVoltage = voltages.reduce((sum, voltage) => sum + voltage, 0) / voltages.length;\n\n//node.warn(\"voltages: \" + voltages)\n\n// Prepare the title for the bar chart with dynamic values divided by 1000\nmsg.title = `Avg${(averageVoltage / 1000).toFixed(2)}V,Min:${(minVoltage / 1000).toFixed(2)}V,Max:${(maxVoltage / 1000).toFixed(2)}V,delta:${((maxVoltage - minVoltage)).toFixed(0)}mV`;\n\nmsg.payload = [{\n    \"labels\": labels,\n    \"data\": [voltages],\n    \"series\": [msg.title] \n}];\n\n//node.warn(\"title: \" + msg.title)\n\nconst messages = {};\n// Loop through each line and extract the voltage\nfor (let i = 0; i < 15; i++) {\n    messages[`cellv_${i + 1}`] = voltages[i];\n}\nmessages['cellv_min'] = minVoltage;\nmessages['cellv_max'] = maxVoltage;\nmessages['cellv_delta'] = maxVoltage - minVoltage;\nmsg.mqtt = [messages];\n\nmsg.mqtt = [...voltages,minVoltage,maxVoltage,maxVoltage - minVoltage];\n\n// Set dynamic ymin and ymax for auto-zooming\nmsg.ui_control = {\n    ymin: minVoltage - 2, // Optional padding\n    ymax: maxVoltage + 2,  // Optional padding\n    title: msg.title\n};\n\n// Return the modified message\nreturn msg;",
        "outputs": 1,
        "timeout": "",
        "noerr": 0,
        "initialize": "",
        "finalize": "",
        "libs": [],
        "x": 1140,
        "y": 540,
        "wires": [
            [
                "3c4d5e6f7g8h9i0j",
                "967347af5d917976",
                "86c188e82de695c4"
            ]
        ]
    },
    {
        "id": "3c4d5e6f7g8h9i0j",
        "type": "ui_chart",
        "z": "210ecc232aa515d1",
        "name": "Voltage Bar Chart",
        "group": "55d02026703d8522",
        "order": 0,
        "width": 0,
        "height": 0,
        "label": "Battery Voltages",
        "chartType": "bar",
        "legend": true,
        "xformat": "auto",
        "interpolate": false,
        "nodata": "No data",
        "dot": true,
        "ymin": "",
        "ymax": "",
        "removeOlder": 1,
        "removeOlderPoints": 1,
        "cutout": "",
        "useOneColor": false,
        "useUTC": false,
        "colors": [
            "#1f77b4",
            "#aec7e8",
            "#ff7f0e",
            "#2ca02c",
            "#98df8a",
            "#d62728",
            "#ff9896",
            "#9467bd",
            "#c5b0d5"
        ],
        "outputs": 1,
        "useDifferentColor": false,
        "className": "",
        "x": 1470,
        "y": 500,
        "wires": [
            []
        ]
    },
    {
        "id": "9f8e7d6c5b4a3b2a",
        "type": "inject",
        "z": "210ecc232aa515d1",
        "name": "Start Flow",
        "props": [],
        "repeat": "10",
        "crontab": "",
        "once": false,
        "onceDelay": 0.1,
        "topic": "",
        "x": 650,
        "y": 540,
        "wires": [
            [
                "1a2b3c4d5e6f7g8h"
            ]
        ]
    },
    {
        "id": "62e960ed8536a2df",
        "type": "mqtt out",
        "z": "210ecc232aa515d1",
        "name": "",
        "topic": "",
        "qos": "",
        "retain": "",
        "respTopic": "",
        "contentType": "",
        "userProps": "",
        "correl": "",
        "expiry": "",
        "broker": "aa30341bcc52e33c",
        "x": 1370,
        "y": 900,
        "wires": []
    },
    {
        "id": "967347af5d917976",
        "type": "change",
        "z": "210ecc232aa515d1",
        "name": "",
        "rules": [
            {
                "t": "set",
                "p": "payload",
                "pt": "msg",
                "to": "mqtt",
                "tot": "msg"
            }
        ],
        "action": "",
        "property": "",
        "from": "",
        "to": "",
        "reg": false,
        "x": 1120,
        "y": 700,
        "wires": [
            [
                "3187e6c77ed69e70",
                "1daa4a98bcddd0a3"
            ]
        ]
    },
    {
        "id": "3187e6c77ed69e70",
        "type": "debug",
        "z": "210ecc232aa515d1",
        "name": "debug 35",
        "active": false,
        "tosidebar": true,
        "console": false,
        "tostatus": false,
        "complete": "false",
        "statusVal": "",
        "statusType": "auto",
        "x": 1390,
        "y": 760,
        "wires": []
    },
    {
        "id": "86c188e82de695c4",
        "type": "debug",
        "z": "210ecc232aa515d1",
        "name": "debug 36",
        "active": false,
        "tosidebar": true,
        "console": false,
        "tostatus": false,
        "complete": "false",
        "statusVal": "",
        "statusType": "auto",
        "x": 1380,
        "y": 600,
        "wires": []
    },
    {
        "id": "1daa4a98bcddd0a3",
        "type": "buffer-parser",
        "z": "210ecc232aa515d1",
        "name": "",
        "data": "payload",
        "dataType": "msg",
        "specification": "spec",
        "specificationType": "ui",
        "items": [
            {
                "type": "int16be",
                "name": "mqtt.0.pylontech5000nr1/cell/c1",
                "offset": 0,
                "length": 1,
                "offsetbit": 0,
                "scale": "1",
                "mask": ""
            },
            {
                "type": "int16be",
                "name": "mqtt.0.pylontech5000nr1/cell/c2",
                "offset": 2,
                "length": 1,
                "offsetbit": 0,
                "scale": "1",
                "mask": ""
            },
            {
                "type": "int16be",
                "name": "mqtt.0.pylontech5000nr1/cell/c3",
                "offset": 4,
                "length": 1,
                "offsetbit": 0,
                "scale": "1",
                "mask": ""
            },
            {
                "type": "int16be",
                "name": "mqtt.0.pylontech5000nr1/cell/c4",
                "offset": 6,
                "length": 1,
                "offsetbit": 0,
                "scale": "1",
                "mask": ""
            },
            {
                "type": "int16be",
                "name": "mqtt.0.pylontech5000nr1/cell/c5",
                "offset": 8,
                "length": 1,
                "offsetbit": 0,
                "scale": "1",
                "mask": ""
            },
            {
                "type": "int16be",
                "name": "mqtt.0.pylontech5000nr1/cell/c6",
                "offset": 10,
                "length": 1,
                "offsetbit": 0,
                "scale": "1",
                "mask": ""
            },
            {
                "type": "int16be",
                "name": "mqtt.0.pylontech5000nr1/cell/c7",
                "offset": 12,
                "length": 1,
                "offsetbit": 0,
                "scale": "1",
                "mask": ""
            },
            {
                "type": "int16be",
                "name": "mqtt.0.pylontech5000nr1/cell/c8",
                "offset": 14,
                "length": 1,
                "offsetbit": 0,
                "scale": "1",
                "mask": ""
            },
            {
                "type": "int16be",
                "name": "mqtt.0.pylontech5000nr1/cell/c9",
                "offset": 16,
                "length": 1,
                "offsetbit": 0,
                "scale": "1",
                "mask": ""
            },
            {
                "type": "int16be",
                "name": "mqtt.0.pylontech5000nr1/cell/c10",
                "offset": 18,
                "length": 1,
                "offsetbit": 0,
                "scale": "1",
                "mask": ""
            },
            {
                "type": "int16be",
                "name": "mqtt.0.pylontech5000nr1/cell/c11",
                "offset": 20,
                "length": 1,
                "offsetbit": 0,
                "scale": "1",
                "mask": ""
            },
            {
                "type": "int16be",
                "name": "mqtt.0.pylontech5000nr1/cell/c12",
                "offset": 22,
                "length": 1,
                "offsetbit": 0,
                "scale": "1",
                "mask": ""
            },
            {
                "type": "int16be",
                "name": "mqtt.0.pylontech5000nr1/cell/c13",
                "offset": 24,
                "length": 1,
                "offsetbit": 0,
                "scale": "1",
                "mask": ""
            },
            {
                "type": "int16be",
                "name": "mqtt.0.pylontech5000nr1/cell/c14",
                "offset": 26,
                "length": 1,
                "offsetbit": 0,
                "scale": "1",
                "mask": ""
            },
            {
                "type": "int16be",
                "name": "mqtt.0.pylontech5000nr1/cell/c15",
                "offset": 28,
                "length": 1,
                "offsetbit": 0,
                "scale": "1",
                "mask": ""
            },
            {
                "type": "int16be",
                "name": "mqtt.0.pylontech5000nr1/cell/cmin",
                "offset": 30,
                "length": 1,
                "offsetbit": 0,
                "scale": "1",
                "mask": ""
            },
            {
                "type": "int16be",
                "name": "mqtt.0.pylontech5000nr1/cell/cmax",
                "offset": 32,
                "length": 1,
                "offsetbit": 0,
                "scale": "1",
                "mask": ""
            },
            {
                "type": "int16be",
                "name": "mqtt.0.pylontech5000nr1/cell/cdelta",
                "offset": 34,
                "length": 1,
                "offsetbit": 0,
                "scale": "1",
                "mask": ""
            }
        ],
        "swap1": "",
        "swap2": "",
        "swap3": "",
        "swap1Type": "swap",
        "swap2Type": "swap",
        "swap3Type": "swap",
        "msgProperty": "payload",
        "msgPropertyType": "str",
        "resultType": "value",
        "resultTypeType": "return",
        "multipleResult": true,
        "fanOutMultipleResult": false,
        "setTopic": true,
        "outputs": 1,
        "x": 950,
        "y": 880,
        "wires": [
            [
                "b1925c8e8f021db2",
                "62e960ed8536a2df"
            ]
        ]
    },
    {
        "id": "b1925c8e8f021db2",
        "type": "debug",
        "z": "210ecc232aa515d1",
        "name": "debug 37",
        "active": false,
        "tosidebar": true,
        "console": false,
        "tostatus": false,
        "complete": "false",
        "statusVal": "",
        "statusType": "auto",
        "x": 1220,
        "y": 1000,
        "wires": []
    },
    {
        "id": "55d02026703d8522",
        "type": "ui_group",
        "name": "Dynamic Power Limiter",
        "tab": "e5b1aeb5977e428a",
        "order": 3,
        "disp": true,
        "width": "6",
        "collapse": false,
        "className": ""
    },
    {
        "id": "aa30341bcc52e33c",
        "type": "mqtt-broker",
        "name": "io",
        "broker": "localhost",
        "port": "1884",
        "clientid": "",
        "autoConnect": true,
        "usetls": false,
        "protocolVersion": "4",
        "keepalive": "60",
        "cleansession": true,
        "autoUnsubscribe": true,
        "birthTopic": "",
        "birthQos": "0",
        "birthPayload": "",
        "birthMsg": {},
        "closeTopic": "",
        "closeQos": "0",
        "closePayload": "",
        "closeMsg": {},
        "willTopic": "",
        "willQos": "0",
        "willPayload": "",
        "willMsg": {},
        "userProps": "",
        "sessionExpiry": ""
    },
    {
        "id": "e5b1aeb5977e428a",
        "type": "ui_tab",
        "name": "Home",
        "icon": "dashboard",
        "order": 1,
        "disabled": false,
        "hidden": false
    }
]`

Thread 15 (2022-12-13):

How Do You Update Code Over WiFi?

maegibbons, 2022-12-13:
Hi

I built a couple of these modules earlier in the year and they have been working great!

I now need to try and use MQTT.

I am not familiar with the Arduino IDE.  How do I push the revised code over wifi?

Krs

Mark

maegibbons, 2022-12-15:
Ok

I sorted it.

You need to login to the same wifi as your existing ESP8266 modules are connected to 1st.

On launching the Ardrino IDE it scans the network.

Load the sketch you want to upload,  then select the port in Tools.  It lists the com ports AND it should now list the ips of ESP8266 devices found on network.

Choose the one you want then hit upload.

That's it

Krs

Mark

Thread 16 (2023-01-06):

newLineBuff in function wakeUpConsole() is 0x0E, 0x0A instead of 0x0D, 0x0A

th-s-op, 2023-01-06:
Hi,

I noticed the following line:

`byte newLineBuff[] = {0x0E, 0x0A};`

and ask myself if 0x0E is really intentional or by mistake, as the Carriage Return code is 0x0D.

kind regards,
Thomas

Thread 17 (2023-01-07):

New firmware 2.8 us2000c, not works.

GuillermoElectrico, 2023-01-07:
With the new version of firmware 2.8 of the us2000c batteries no longer works. It seems that the port is now initialized to 115200 by default, but the problem I see is that it doesn't seem to accept the newline every time a request is sent.

If I use esp and send a request, for example, help, it does nothing, but if I disconnect esp and connect directly to a computer and do the same query using terminal1.9b (with +CR/LF enabled) I get an error of Unrecognized command and it appears to me that the query consists of two help followed by no spaces, that is, "helphelp".

I've gone through the code and tried alternatives to \n or even adding \r to no avail.

It has been working perfectly until I updated to version 2.8 (I added a new battery and upgraded the existing ones).

I have tried everything, including disabling the wakeUpConsole so that it is at a fixed 115200, but without results.

Any idea what may be going on?

gerdluthe, 2023-01-07:
What about downgrading all batterys to the working one you used before.
what's the benefits of having an actual 2.8 firmware as pylontech never released an info whats new in the firmware releases

GuillermoElectrico, 2023-01-07:
I don't know about the improvements, but what I do know is that a us2000b has bloated me.

I have 4 us2000c and 6 (well now 5) us2000b plus. When assembling a new us2000c, which came with the latest version and as recommended, it must be set as master, one of the us2000b has failed, it seems overloaded or similar. To avoid further problems, they recommended me to update the rest of us2000c to 2.8 (us2000b were already with 3.4).

Since the update, when loading, it doesn't do weird things anymore and it's stable. But now I have found the problem that the esp8266 does not work in any us2000c (in the us2000b it does, but since the set exceeds 8, I cannot use it as a master).

But it's weird, from a PC it works without a problem (at 115200) but the esp8266 doesn't, and as I mentioned, it seems like a line break termination problem or similar. But I don't give up on it.

GuillermoElectrico, 2023-01-14:
Found the problem, it is not a problem of the code, but of the hardware. Now with the new version of the firm, the MAX3232 converter that has been working perfectly at 3.3V powered from the NodeMCU, no longer works. Generates weird and erroneous characters.

It has been to put a level converter and feed it at 5V, and it works fine from the first moment.

The funny thing is that with the previous versions of the firm, and US2000B batteries, it had no problems, but with the new US2000C it is more sensitive.

https://github.com/irekzielinski/Pylontech-Battery-Monitoring/issues/5#issuecomment-1003703097

As I have searched, there have already been others with the same problem. My solution, to feed the MAX3232 to 5V and mount a level converter between the ESP8266.

Closed 2023-01-14.

Thread 18 (2023-02-22):

code adjustment for Pylontech H48050

tomasvida, 2023-02-22:
Hello! Couldn't the code be adapted for the BMS SC0500A pylons with H48050 batteries? Your code is perfect, but on the command of the PWR to the serial console, my batteries come to me absolutely, so the parsing then does not work.
I am not proficient in coding, so unfortunately I do not have to make adequate modification of code.

Thread 19 (2023-03-04):

Is it possible to compile and load ino file to esp8266 without any issue ????

Manu0171discord, 2023-03-04:
Hi,
I disovered this Github  file to do the same, to get information from my pylontech battery,

I tried without any sucess to compile and load the ino file with arduino ide, using MQTT , so I uncommented the ligne 17

I did all the same as described into the readme but I got an error

D:\PylontechMonitoring\PylontechMonitoring.ino:29:10: fatal error: PubSubClient.h: No such file or directory

I did not do the connection yet to the pylontech battery, only the esp8266 plugged to the PC to compile and load the ino file
in order to test the send command to Mosquitto broker and check if norered can get and read data from the esp8266 even if the esp8266 is not connected to the pylontech battery

Did anyone already have this issue ?

I thank you for your support
Manu

Manu0171discord, 2023-03-04:
I found the solution => https://www.youtube.com/watch?v=Wv1AicTy-ks

Thread 22 (2023-07-28):

Software und/or hardware modifications for Pylontech US3000C

alexandergeiler, 2023-07-28:
Hi,

I use [irekzielinski](https://github.com/irekzielinski) [Pylontech-Battery-Monitoring](https://github.com/irekzielinski/Pylontech-Battery-Monitoring) solutions since years at 2 different locations.
At the first location, I have a Pylontech US2000 at the second location I have a Pylontech US3000.
The solution is working fine.
I did some small modifications, SYSLOG support, change the OTA update procedure, diffrent landing page, ... but the hole functionallity is still from [irekzielinski](https://github.com/irekzielinski)

I ordered a new Pylontech US3000C to replace the Pylontech US2000.
I tried to connect it to my existing WEMOS but a communications was not possible.

I didn't see that irekzielinski updated his documentation and found the the description of how to wire it up now at:
[issue5](https://github.com/irekzielinski/Pylontech-Battery-Monitoring/issues/5)

Also after changing the wiring, I am not able to communicate with the Pylontech US3000C.
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

According to:
[issue1](https://github.com/irekzielinski/Pylontech-Battery-Monitoring/issues/1)
[Wibet10](https://github.com/Wibet10) added a
IIC I2C Logic level converter bi-directional module
and changed the source code

According to:
[issue5](https://github.com/irekzielinski/Pylontech-Battery-Monitoring/issues/5)
The old code is still working without a change.
[mduchain](https://github.com/mduchain) identified that the "drop to 1200 baud or send that byte sequence to communicate" is not needed anymore.
And few days later [mduchain](https://github.com/mduchain) write "I avoid this by sending a few CR/LF before sending the actual command – an alternative wakeup sequence of sorts."

---
Now my question?
Is anyone using the orginal source code from [Pylontech-Battery-Monitoring](https://github.com/irekzielinski/Pylontech-Battery-Monitoring) to communicate with a Pylontech US3000C?
Is it working without a IIC I2C Logic level converter bi-directional module?

commander-bln, 2023-07-28:
I use the original code with an ESP32 Dev Kit V1 without level converter, only TRANSCEIVER BREAKOUT - MAX3232 from SparkFUN and this works fine with 3X US5000 on Port Console

alexandergeiler, 2023-07-28:
@commander-bln your answer is really helpful.
The "wakeUpConsole();" is still active in the code?

I have a cheap MAX3232 from Aliexpress that was working with my Pylontech 2000. May be I should try the MAX3232 from SparkFUN.

commander-bln, 2023-07-28:
hello
your name sounds like german??

I have 3 "TRANSCEIVER BREAKOUT - MAX3232 from SparkFUN" and all worked on breadboard.
i heard sometimes the user had problems with the transceiver and tryed multiple , till they get lucky.

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

alexandergeiler, 2023-07-28:
Hi [commander-bln](https://github.com/commander-bln),
ja, Deutscher :-)
Ich habe einmal den "orginal " MAX3232 from SparkFUN an meiner US3000 und einen "noname" MAX3232 an meiner US2000 (die ich gerade versuche zu tauschen).
Ich teste das mal mit dem orginal MAX3232 from SparkFUN
Danke für Dein Bild!

commander-bln, 2023-07-28:
OK, ich hatte auch am Anfang Fehler, deshalb hatte ich mit Fritzing PCB und Schaltplan gezeichnet, und dann hatte ich auch schnell die Fehlverdrahtung auf dem Breadboard entdeckt.
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

Auf dem Board sind auch 4-5 Kondensatoren bestückt, vielleicht macht das den Transceiver Stabiler..

alexandergeiler, 2023-07-29:
Ich schaue nochmal. Auf die schnelle habe ich es nicht hinbekommen.
Danke erstmal.
Eine US5000 ist baugleich mit einer US300C?

guybw, 2023-07-29:
If it helps, someone has forked this to support the us5000 and us3000c so that might help ?

alexandergeiler, 2023-07-29:
I tested the fork from Wibet10 too.
My US2000 and my US3000 are connected via the "console" port.
Several people seems to be using the B/RS485 port.

Can someone that is using a US3000C decibe, if he is using the "console" or the "B/RS485" port.

Startertrek, 2023-07-30:
I am using console port. Connected are 1 x US2000c and 1 x US3000c, both are reading stable

commander-bln, 2023-07-30:
I am using 3x us5000 on Port  console with no Problems...using esp32.with converter tll2seitial Von Unterwegs gesendet.
-------- Ursprüngliche Nachricht --------Von: Startertrek ***@***.***> Datum: 30.07.23  21:01  (GMT+01:00) An: irekzielinski/Pylontech-Battery-Monitoring ***@***.***> Cc: commander-bln ***@***.***>, Mention ***@***.***> Betreff: Re: [irekzielinski/Pylontech-Battery-Monitoring] Software und/or hardware modifications for Pylontech US3000C (Issue #22)
I am using console port. Connected are 1 x US2000c and 1 x US3000c, both are reading stable

—Reply to this email directly, view it on GitHub, or unsubscribe.You are receiving this because you were mentioned.Message ID: ***@***.***>

alexandergeiler, 2023-07-31:
@Startertrek, nice to know that it works for you with a US3000C.

So you use the unchanged code from irekzielinski. Including the wakeup call with 1200 baud?

Are you using the SpaarkFun MAX3232 transceiver or a "none".
Are you using an I2C IIC logic level converter 5V~3.3V?

Last question, all your jumper at the US3000C are looking to the ADD desciption at the batterie?

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

commander-bln, 2023-08-05:
Here is my Breadboard Wiring that Works with US5000 and the standard code
ESP32 Dev Kit V1 + MAX3232 and konnector RJ45 , i use standard RJ45 cable

the only thing i have make with my First Battery, i connect with Battery View 3.0.24 to look for Firmware/Update

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

alexandergeiler, 2023-08-25:
Hi all,

it was a layer 8 problem.
It is now working with a SparkFun MAX323 chip without the I2C IIC logic level converter (like in the screenshot from @commander-bln.
I use the code @irekzielinski

Thank´s to all for you support!

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

Closed 2023-08-25.

Thread 25 (2023-08-22):

US3000C not respondig to the "pwr" string

Mirko-94-19, 2023-08-22:
I have 4 batteries, the master is US3000C and slave are mixed US2000C and US2000.
I have tried to use you sketch but the battery was not responding, then I connect directly to the console port using putty and it seems that the command to read the battery status is "bat" and not "pwr"

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

Not sure why it finds 14 batteries and why it differs from standard "pwr" command, maybe due to a new firmware

cschweers, 2023-08-23:
Your interpretation of the '_bat_' command is incorrect. This command shows the data for all **15** LiIon cells that make up the battery you are currently connected to.

Mirko-94-19, 2023-08-23:
Yes, you are right, thanks!
I misunderstood the "help" and the serial output.
I tested one more time after a battery power cycle and now it is responding correctly to the "pwr"string but the ESP is not updating the data over MQTT, not sure why
Tested also with different MAX3232 chip but it still the same, over MQTT I get only "Available": "online"

Thread 27 (2023-12-19):

wakeUpConsole() doesn't make sense on the serial console port

th-s-op, 2023-12-19:
I have to state that the need to switch baud rates and send the "~20014682C0048520FCC3\r" string is a mistake that results from not understanding the different Pylontech ports and protocols. While this is the correct method to switch the RS485 (!) port from the semi-binary packet/frame mode to console mode, it is not necessary to be done when the RS232 (!) Console port is used.

The code WOULD make sense if the RS485 port with an RS485 transceiver is used.
Using the code on the Console port doesn't do any harm but sends unnecessary garbage to the console shell.

See the RS485 protocol documentation (https://github.com/Frankkkkk/python-pylontech/blob/master/RS485-protocol-pylon-low-voltage-V3.3-20180821.pdf). The above string can be found there: "~" is the "Start of Information" byte, followed by protocol version, address, etc. up to a checksum and the "End Code" (\r).

Summary:
port labeled "Console": RS232 interface, speaks "console shell"
port labeled "RS485": RS485 interface, speaks frame based "Pylontech Low Voltage Protocol" but can be switched to "console shell"
port labeled "CAN": CAN bus interface, speaks CAN protocol

th-s-op, 2023-12-22:
Also, even when using the RS485 port, it would be good to check if it's already in "Console Mode" or still in packet-frame-mode. If you switch to "Console Mode" using the "~20014682C0048520FCC3\r" packet, it's good practice to also exit "Console Mode" using the "cmdquit" command (which is ONLY available in the console mode on the RS485 port and not in any of the admin/user modes in the RS232 console). There is software which expects RS485 on the RS485 port and the "Console Mode" should be a (temporary) exception on this port. Even Pylontech's "Batteryview.exe" sends a "cmdquit" when you exit the program.

Thread 28 (2023-12-21):

FIX IP and MQTT Connection error

AditaNi, 2023-12-21:
Hi,

Trying to use fix IP, and by compilation I got:
C:\Users\Fuji\Downloads\PylontechMonitoring\PylontechMonitoring.ino: In function 'void setup()':
C:\Users\Fuji\Downloads\PylontechMonitoring\PylontechMonitoring.ino:20:12: error: conversion from 'const char [14]' to 'IPAddress' is ambiguous
   20 | #define IP "192.168.188.5"
      |            ^~~~~~~~~~~~~~~
C:\Users\Fuji\Downloads\PylontechMonitoring\PylontechMonitoring.ino:108:18: note: in expansion of macro 'IP'
  108 |      WiFi.config(IP, GATEWAY, NETMASK, DNS);

MQTT :

01 - 00:00 | Wait for WIFI Connection
01 - 00:00 | Wait for WIFI Connection
01 - 00:00 | Wait for WIFI Connection
01 - 00:00 | Wait for WIFI Connection
01 - 00:00 | Wait for WIFI Connection
01 - 00:00 | Wait for WIFI Connection
01 - 00:00 | Wait for WIFI Connection
01 - 00:00 | Wait for WIFI Connection
01 - 00:00 | Wait for WIFI Connection
01 - 00:00 | Wait for WIFI Connection
01 - 00:00 | Boot event
01 - 00:00 | Failed to connect to MQTT server.
01 - 00:01 | Failed to connect to MQTT server.
01 - 00:02 | Failed to connect to MQTT server.
01 - 00:03 | Failed to connect to MQTT server.
01 - 00:04 | New baud: 115200
01 - 00:04 | Failed to connect to MQTT server.
01 - 00:05 | Failed to connect to MQTT server.
01 - 00:06 | Failed to connect to MQTT server.
01 - 00:07 | Failed to connect to MQTT server.
01 - 00:08 | Failed to connect to MQTT server.
01 - 00:09 | Failed to connect to MQTT server.
01 - 00:10 | Failed to connect to MQTT server.
01 - 00:11 | Failed to connect to MQTT server.
01 - 00:12 | Failed to connect to MQTT server.
01 - 00:13 | Failed to connect to MQTT server.
01 - 00:14 | Failed to connect to MQTT server.
01 - 00:15 | Failed to connect to MQTT server.
01 - 00:16 | Failed to connect to MQTT server.
01 - 00:17 | Failed to connect to MQTT server.
01 - 00:18 | Failed to connect to MQTT server.
01 - 00:19 | Failed to connect to MQTT server.
01 - 00:20 | Failed to connect to MQTT server.
01 - 00:21 | Failed to connect to MQTT server.
01 - 00:22 | Failed to connect to MQTT server.
01 - 00:23 | Failed to connect to MQTT server.
01 - 00:24 | Failed to connect to MQTT server.

And Mosquitto Broker says:

2023-12-21 22:12:35: New connection from 192.168.188.5:49743 on port 1883.
2023-12-21 22:12:35: Client <unknown> closed its connection.
2023-12-21 22:13:36: New connection from 192.168.188.5:49565 on port 1883.
2023-12-21 22:13:36: Client <unknown> closed its connection.

I have other devices with MQTT connection and they are working fine.

Regards
Adrian

AditaNi, 2023-12-21:
Update_1: After updating the Arduino IDE and all the libraries, the ESP has managed to establish a MQTT Connection.

Closed 2023-12-21.

Thread 29 (2024-01-23):

Feature not  a issue! - it will be possible to connect this to an lv hub from pylontech?

AditaNi, 2024-01-23:
Hi,

i have a configuration like 7 pylontech us2000c x 2 = 14 bateries.
In order to connect them(the batteries) with the growatt sph4000 inverter i need a lv hub.

It will be nice if this sw  for monitoring the batteries can be connected to the hub in order to monitor with one esp8266 all 14 batteries.

it is possible?

what i'm getting wright now is...see attached foto.
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

Regards
Adrian

Thread 30 (2024-06-07):

pwr output changed

alexandergeiler, 2024-06-07:
Hi,
I have a pylontech US2000B and a pylontech US3000A and I have been using @irekzielinski Pylontech-Battery-Monitoring tool since more than a year.
I am getting the data from pylontech and publish it to my moskitto MQTT broker and use it there.
Normally I switch off my battery at SOC < 20%, but last week my own program did not work and my US2000B battery went down to 0%.

Since then I have not been able to get any data from my US2000B battery.
The output has been changed:
US2000B:
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
US3000A
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

Sure, I still get data from US3000A, but the irekzielinski program cannot read the data from US2000B.

Has anyone else seen this? Does anyone know how to change the output format?

alexandergeiler, 2024-06-09:
I don´t know how, but my DIP configuration was wrong.
I changed all DIP switched to "OFF" and it is working again.
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

Rustimation, 2024-11-15:
I just discovered your issue after I fixed the problem differently.
Strangely though, I have all DIP switches set to OFF and still get the "other" response to the pwr command - which in turn renders JSON and MQTT output unusable. I have therefore changed Ireneus' software a bit to reflext the new parameter positions.
Please see closed issue #31 "New Pylontech Firmware - New Data Structure - New Problems".
Rgds
Chris

Closed 2024-06-09.

Thread 31 (2024-11-14):

New Pylontech Firmware - New Data Structure - New Problems

Rustimation, 2024-11-14:
After a year or so, I bought another Pylontech battery, this time a US5000. Firmware is from 24-05-13
This firmware is causing problems with the JSON and MQTT output. It shows "Alarm!" and 0 Voltage which is incorrect, since the "pwr" command shows a perfecty working battery.
Pylontech added some more parameters to the _pwr_ output changing the table structure.
Ireneus' sketch parses the result of the built-in _pwr_ comand output by reading text at e.g. offset 55 for the battery's _base state_ and some other values. However _base state_ can now be found at offset 91. The new offset varies, so just adding 36 to the offset won't help.
You need to change the offset in lines 543 and 550 to 564.
In addition the text "Absent" which is used to end the iteration across the number of battery modules, is still remaining at offset 55 causing the loop to go to the max of 8 batteries which in turn produces empty values. So, part of the loop code has to be rewritten as well (line 544). As soon as I come around, I will add a link to the corrected sketch.
Rgds
Chris

Rustimation, 2024-11-15:
As promised. Please find the updated code below:
 [can also be found here](https://www.rustimation.eu/index.php/solar-pylontech-akku-ueber-konsole-aufwecken/) (German language).
`
 #include <ESP8266WiFi.h>
#include <ESP8266mDNS.h>
#include <ArduinoOTA.h>
#include <ESP8266WebServer.h>
#include <ESP8266WebServer.h>
#include <SimpleTimer.h>
#include <TimeLib.h> //https://github.com/PaulStoffregen/Time
#include <ntp_time.h>
#include <circular_log.h>

//IMPORTANT: Specify your WIFI settings:
#define WIFI_SSID "--YOUR SSID HERE --"
#define WIFI_PASS "-- YOUR PASSWORD HERE --"

//IMPORTANT: Uncomment this line if you want to enable MQTT (and fill correct MQTT_ values below):
//#define ENABLE_MQTT

#ifdef ENABLE_MQTT
//NOTE 1: if you want to change what is pushed via MQTT - edit function: pushBatteryDataToMqtt.
//NOTE 2: MQTT_TOPIC_ROOT is where battery will push MQTT topics. For example "soc" will be pushed to: "home/grid_battery/soc"
/*#define MQTT_SERVER        "192.168.0.6"
#define MQTT_PORT          1883
#define MQTT_USER          ""
#define MQTT_PASSWORD      ""
#define MQTT_TOPIC_ROOT    "home/grid_battery/"  //this is where mqtt data will be pushed
#define MQTT_PUSH_FREQ_SEC 2  //maximum mqtt update frequency in seconds*/

#include <PubSubClient.h>
WiFiClient espClient;
PubSubClient mqttClient(espClient);
#endif //ENABLE_MQTT

char g_szRecvBuff[7000];

ESP8266WebServer server(80);
SimpleTimer timer;
circular_log<7000> g_log;
bool ntpTimeReceived = false;
int g_baudRate = 0;

void Log(const char* msg)
{
  g_log.Log(msg);
}

void setup() {
  pinMode(LED_BUILTIN, OUTPUT);
  digitalWrite(LED_BUILTIN, HIGH);//high is off

  // put your setup code here, to run once:
  WiFi.mode(WIFI_STA);
  WiFi.persistent(false); //our credentialss are hardcoded, so we don't need ESP saving those each boot (will save on flash wear)
  WiFi.hostname("PylontechBattery");
  WiFi.begin(WIFI_SSID, WIFI_PASS);

  for(int ix=0; ix<10; ix++)
  {
    if(WiFi.status() == WL_CONNECTED)
    {
      break;
    }

    delay(1000);
  }

  ArduinoOTA.setHostname("GarageBattery");
  ArduinoOTA.begin();
  server.on("/", handleRoot);
  server.on("/log", handleLog);
  server.on("/req", handleReq);
  server.on("/jsonOut", handleJsonOut);
  server.on("/reboot", [](){
    ESP.restart();
  });

  server.begin();

  syncTime();

#ifdef ENABLE_MQTT
  mqttClient.setServer(MQTT_SERVER, MQTT_PORT);
#endif

  Log("Boot event");
}

void handleLog()
{
  server.send(200, "text/html", g_log.c_str());
}

void switchBaud(int newRate)
{
  if(g_baudRate == newRate)
  {
    return;
  }

  if(g_baudRate != 0)
  {
    Serial.flush();
    delay(20);
    Serial.end();
    delay(20);
  }

  char szMsg[50];
  snprintf(szMsg, sizeof(szMsg)-1, "New baud: %d", newRate);
  Log(szMsg);

  Serial.begin(newRate);
  g_baudRate = newRate;

  delay(20);
}

void waitForSerial()
{
  for(int ix=0; ix<150;ix++)
  {
    if(Serial.available()) break;
    delay(10);
  }
}

int readFromSerial()
{
  memset(g_szRecvBuff, 0, sizeof(g_szRecvBuff));
  int recvBuffLen = 0;
  bool foundTerminator = true;

  waitForSerial();

  while(Serial.available())
  {
    char szResponse[256] = "";
    const int readNow = Serial.readBytesUntil('>', szResponse, sizeof(szResponse)-1); //all commands terminate with "$$\r\n\rpylon>" (no new line at the end)
    if(readNow > 0 &&
       szResponse[0] != '\0')
    {
      if(readNow + recvBuffLen + 1 >= (int)(sizeof(g_szRecvBuff)))
      {
        Log("WARNING: Read too much data on the console!");
        break;
      }

      strcat(g_szRecvBuff, szResponse);
      recvBuffLen += readNow;

      if(strstr(g_szRecvBuff, "$$\r\n\rpylon"))
      {
        strcat(g_szRecvBuff, ">"); //readBytesUntil will skip this, so re-add
        foundTerminator = true;
        break; //found end of the string
      }

      if(strstr(g_szRecvBuff, "Press [Enter] to be continued,other key to exit"))
      {
        //we need to send new line character so battery continues the output
        Serial.write("\r");
      }

      waitForSerial();
    }
  }

  if(recvBuffLen > 0 )
  {
    if(foundTerminator == false)
    {
      Log("Failed to find pylon> terminator");
    }
  }

  return recvBuffLen;
}

bool readFromSerialAndSendResponse()
{
  const int recvBuffLen = readFromSerial();
  if(recvBuffLen > 0)
  {
    server.sendContent(g_szRecvBuff);
    return true;
  }

  return false;
}

bool sendCommandAndReadSerialResponse(const char* pszCommand)
{
  switchBaud(115200);

  if(pszCommand[0] != '\0')
  {
    Serial.write(pszCommand);
  }
  Serial.write("\n");

  const int recvBuffLen = readFromSerial();
  if(recvBuffLen > 0)
  {
    return true;
  }

  //wake up console and try again:
  wakeUpConsole();

  if(pszCommand[0] != '\0')
  {
    Serial.write(pszCommand);
  }
  Serial.write("\n");

  return readFromSerial() > 0;
}

void handleReq()
{
  bool respOK;
  if(server.hasArg("code") == false)
  {
    respOK = sendCommandAndReadSerialResponse("");
  }
  else
  {
    respOK = sendCommandAndReadSerialResponse(server.arg("code").c_str());
  }

  if(respOK)
  {
    server.send(200, "text/plain", g_szRecvBuff);
  }
  else
  {
    server.send(500, "text/plain", "????");
  }
}

void handleJsonOut()
{
  if(sendCommandAndReadSerialResponse("pwr") == false)
  {
    server.send(500, "text/plain", "Failed to get response to 'pwr' command");
    return;
  }

  parsePwrResponse(g_szRecvBuff);
  prepareJsonOutput(g_szRecvBuff, sizeof(g_szRecvBuff));
  server.send(200, "application/json", g_szRecvBuff);
}

void handleRoot() {
  unsigned long days = 0, hours = 0, minutes = 0;
  unsigned long val = os_getCurrentTimeSec();

  days = val / (3600*24);
  val -= days * (3600*24);

  hours = val / 3600;
  val -= hours * 3600;

  minutes = val / 60;
  val -= minutes*60;

  static char szTmp[2500] = "";
  snprintf(szTmp, sizeof(szTmp)-1, "<html><b>Garage Battery</b><br>Time GMT: %d/%02d/%02d %02d:%02d:%02d (%s)<br>Uptime: %02d:%02d:%02d.%02d<br><br>free heap: %u<br>Wifi RSSI: %d<BR>Wifi SSID: %s",
            year(), month(), day(), hour(), minute(), second(), "GMT",
            (int)days, (int)hours, (int)minutes, (int)val,
            ESP.getFreeHeap(), WiFi.RSSI(), WiFi.SSID().c_str());

  strncat(szTmp, "<BR><a href='/log'>Runtime log</a><HR>", sizeof(szTmp)-1);
  strncat(szTmp, "<form action='/req' method='get'>Command:<input type='text' name='code'/><input type='submit'></form><a href='/req?code=pwr'>Power</a> | <a href='/req?code=help'>Help</a> | <a href='/req?code=log'>Event Log</a> | <a href='/req?code=time'>Time</a>", sizeof(szTmp)-1);
  strncat(szTmp, "</html>", sizeof(szTmp)-1);

  server.send(200, "text/html", szTmp);
}

unsigned long os_getCurrentTimeSec()
{
  static unsigned int wrapCnt = 0;
  static unsigned long lastVal = 0;
  unsigned long currentVal = millis();

  if(currentVal < lastVal)
  {
    wrapCnt++;
  }

  lastVal = currentVal;
  unsigned long seconds = currentVal/1000;

  //millis will wrap each 50 days, as we are interested only in seconds, let's keep the wrap counter
  return (wrapCnt*4294967) + seconds;
}

void syncTime()
{
  //get time from NTP
  time_t currentTimeGMT = getNtpTime();
  if(currentTimeGMT)
  {
    ntpTimeReceived = true;
    setTime(currentTimeGMT);
  }
  else
  {
    timer.setTimeout(5000, syncTime); //try again in 5 seconds
  }
}

void wakeUpConsole()
{
  switchBaud(1200);

  //byte wakeUpBuff[] = {0x7E, 0x32, 0x30, 0x30, 0x31, 0x34, 0x36, 0x38, 0x32, 0x43, 0x30, 0x30, 0x34, 0x38, 0x35, 0x32, 0x30, 0x46, 0x43, 0x43, 0x33, 0x0D};
  //Serial.write(wakeUpBuff, sizeof(wakeUpBuff));
  Serial.write("~20014682C0048520FCC3\r");
  delay(1000);

  byte newLineBuff[] = {0x0E, 0x0A};
  switchBaud(115200);

  for(int ix=0; ix<10; ix++)
  {
    Serial.write(newLineBuff, sizeof(newLineBuff));
    delay(1000);

    if(Serial.available())
    {
      while(Serial.available())
      {
        Serial.read();
      }

      break;
    }
  }
}

#define MAX_PYLON_BATTERIES 8

struct pylonBattery
{
  bool isPresent;
  long  soc;     //Coulomb in %
  long  voltage; //in mW
  long  current; //in mA, negative value is discharge
  long  tempr;   //temp of case or BMS?
  long  cellTempLow;
  long  cellTempHigh;
  long  cellVoltLow;
  long  cellVoltHigh;
  char isAbsent[7]; // new variable for "Absent" Marker to stop iteration <<<<<<<<<<<<<<<<<<<<<<<<<<<<<
  char baseState[9];    //Charge | Dischg | Idle
  char voltageState[9]; //Normal
  char currentState[9]; //Normal
  char tempState[9];    //Normal
  char time[20];        //2019-06-08 04:00:29
  char b_v_st[9];       //Normal  (battery voltage?)
  char b_t_st[9];       //Normal  (battery temperature?)

  bool isCharging()    const { return strcmp(baseState, "Charge")   == 0; }
  bool isDischarging() const { return strcmp(baseState, "Dischg")   == 0; }
  bool isIdle()        const { return strcmp(baseState, "Idle")     == 0; }
  bool isBalancing()   const { return strcmp(baseState, "Balance")  == 0; }

  bool isNormal() const
  {
    if(isCharging()    == false &&
       isDischarging() == false &&
       isIdle()        == false &&
       isBalancing()   == false)
    {
      return false; //base state looks wrong!
    }

    return  strcmp(voltageState, "Normal") == 0 &&
            strcmp(currentState, "Normal") == 0 &&
            strcmp(tempState,    "Normal") == 0 &&
            strcmp(b_v_st,       "Normal") == 0 &&
            strcmp(b_t_st,       "Normal") == 0 ;
  }
};

struct batteryStack
{
  int batteryCount;
  int soc;  //in %, if charging: average SOC, otherwise: lowest SOC
  int temp; //in mC, if highest temp is > 15C, this will show the highest temp, otherwise the lowest
  long currentDC;    //mAh current going in or out of the battery
  long avgVoltage;    //in mV
  char baseState[9];  //Charge | Dischg | Idle | Balance | Alarm!

  pylonBattery batts[MAX_PYLON_BATTERIES];

  bool isNormal() const
  {
    for(int ix=0; ix<MAX_PYLON_BATTERIES; ix++)
    {
      if(batts[ix].isPresent &&
         batts[ix].isNormal() == false)
      {
        return false;
      }
    }

    return true;
  }

  //in wH
  long getPowerDC() const
  {
    return (long)(((double)currentDC/1000.0)*((double)avgVoltage/1000.0));
  }

  //wH estimated current on AC side (taking into account Sofar ME3000SP losses)
  long getEstPowerAc() const
  {
    double powerDC = (double)getPowerDC();
    if(powerDC == 0)
    {
      return 0;
    }
    else if(powerDC < 0)
    {
      //we are discharging, on AC side we will see less power due to losses
      if(powerDC < -1000)
      {
        return (long)(powerDC*0.94);
      }
      else if(powerDC < -600)
      {
        return (long)(powerDC*0.90);
      }
      else
      {
        return (long)(powerDC*0.87);
      }
    }
    else
    {
      //we are charging, on AC side we will have more power due to losses
      if(powerDC > 1000)
      {
        return (long)(powerDC*1.06);
      }
      else if(powerDC > 600)
      {
        return (long)(powerDC*1.1);
      }
      else
      {
        return (long)(powerDC*1.13);
      }
    }
  }
};

batteryStack g_stack;

long extractInt(const char* pStr, int pos)
{
  return atol(pStr+pos);
}

void extractStr(const char* pStr, int pos, char* strOut, int strOutSize)
{
  strOut[strOutSize-1] = '\0';
  strncpy(strOut, pStr+pos, strOutSize-1);
  strOutSize--;

  //trim right
  while(strOutSize > 0)
  {
    if(isspace(strOut[strOutSize-1]))
    {
      strOut[strOutSize-1] = '\0';
    }
    else
    {
      break;
    }

    strOutSize--;
  }
}

/* Output has mixed \r and \r\n
pwr

@

Power Volt   Curr   Tempr  Tlow   Thigh  Vlow   Vhigh  Base.St  Volt.St  Curr.St  Temp.St  Coulomb  Time                 B.V.St   B.T.St

1     49735  -1440  22000  19000  19000  3315   3317   Dischg   Normal   Normal   Normal   93%      2019-06-08 04:00:30  Normal   Normal

....

8     -      -      -      -      -      -      -      Absent   -        -        -        -        -                    -        -

Command completed successfully

$$

pylon
*/
bool parsePwrResponse(const char* pStr)
{
  if(strstr(pStr, "Command completed successfully") == NULL)
  {
    return false;
  }

  int chargeCnt    = 0;
  int dischargeCnt = 0;
  int idleCnt      = 0;
  int alarmCnt     = 0;
  int socAvg       = 0;
  int socLow       = 0;
  int tempHigh     = 0;
  int tempLow      = 0;

  memset(&g_stack, 0, sizeof(g_stack));

  for(int ix=0; ix<MAX_PYLON_BATTERIES; ix++)
  {
    char szToFind[32] = "";
    snprintf(szToFind, sizeof(szToFind)-1, "\r\r\n%d     ", ix+1);

    const char* pLineStart = strstr(pStr, szToFind);
    if(pLineStart == NULL)
    {
      return false;
    }

    pLineStart += 3; //move past \r\r\n

    extractStr(pLineStart, 91, g_stack.batts[ix].baseState, sizeof(g_stack.batts[ix].baseState));// ##########  new offset 91 instead of 50
    extractStr(pLineStart, 55, g_stack.batts[ix].isAbsent, sizeof(g_stack.batts[ix].isAbsent));  // ########## new variable for check of "Absent" text #########

    if(strcmp(g_stack.batts[ix].isAbsent, "Absent") == 0)                                        // ########## changed from baseState to isAbsent
    {
      g_stack.batts[ix].isPresent = false;
    }
    else
    {
      g_stack.batts[ix].isPresent = true;
      extractStr(pLineStart, 100, g_stack.batts[ix].voltageState, sizeof(g_stack.batts[ix].voltageState)); // ########## new offset
      extractStr(pLineStart, 109, g_stack.batts[ix].currentState, sizeof(g_stack.batts[ix].currentState)); // ########## new offset
      extractStr(pLineStart, 118, g_stack.batts[ix].tempState, sizeof(g_stack.batts[ix].tempState));       // ########## new offset
      extractStr(pLineStart, 136, g_stack.batts[ix].time, sizeof(g_stack.batts[ix].time));                 // ########## new offset
      extractStr(pLineStart, 157, g_stack.batts[ix].b_v_st, sizeof(g_stack.batts[ix].b_v_st));             // ########## new offset
      extractStr(pLineStart, 166, g_stack.batts[ix].b_t_st, sizeof(g_stack.batts[ix].b_t_st));             // ########## new offset
      g_stack.batts[ix].voltage = extractInt(pLineStart, 6);
      g_stack.batts[ix].current = extractInt(pLineStart, 13);
      g_stack.batts[ix].tempr   = extractInt(pLineStart, 20);
      g_stack.batts[ix].cellTempLow    = extractInt(pLineStart, 27);
      g_stack.batts[ix].cellTempHigh   = extractInt(pLineStart, 43);                                       // ########## new offset
      g_stack.batts[ix].cellVoltLow    = extractInt(pLineStart, 59);                                       // ########## new offset
      g_stack.batts[ix].cellVoltHigh   = extractInt(pLineStart, 75);                                       // ########## new offset
      g_stack.batts[ix].soc            = extractInt(pLineStart, 127);                                      // ########## new offset

      //////////////////////////////// Post-process ////////////////////////
      g_stack.batteryCount++;
      g_stack.currentDC += g_stack.batts[ix].current;
      g_stack.avgVoltage += g_stack.batts[ix].voltage;
      socAvg += g_stack.batts[ix].soc;

      if(g_stack.batts[ix].isNormal() == false){ alarmCnt++; }
      else if(g_stack.batts[ix].isCharging()){chargeCnt++;}
      else if(g_stack.batts[ix].isDischarging()){dischargeCnt++;}
      else if(g_stack.batts[ix].isIdle()){idleCnt++;}
      else{ alarmCnt++; } //should not really happen!

      if(g_stack.batteryCount == 1)
      {
        socLow = g_stack.batts[ix].soc;
        tempLow  = g_stack.batts[ix].cellTempLow;
        tempHigh = g_stack.batts[ix].cellTempHigh;
      }
      else
      {
        if(socLow > g_stack.batts[ix].soc){socLow = g_stack.batts[ix].soc;}
        if(tempHigh < g_stack.batts[ix].cellTempHigh){tempHigh = g_stack.batts[ix].cellTempHigh;}
        if(tempLow > g_stack.batts[ix].cellTempLow){tempLow = g_stack.batts[ix].cellTempLow;}
      }

    }
  }

  //now update stack state:
  g_stack.avgVoltage /= g_stack.batteryCount;
  g_stack.soc = socLow;

  if(tempHigh > 15000) //15C
  {
    g_stack.temp = tempHigh; //in the summer we highlight the warmest cell
  }
  else
  {
    g_stack.temp = tempLow; //in the winter we focus on coldest cell
  }

  if(alarmCnt > 0)
  {
    strcpy(g_stack.baseState, "Alarm!");
  }
  else if(chargeCnt == g_stack.batteryCount)
  {
    strcpy(g_stack.baseState, "Charge");
    g_stack.soc = (int)(socAvg / g_stack.batteryCount);
  }
  else if(dischargeCnt == g_stack.batteryCount)
  {
    strcpy(g_stack.baseState, "Dischg");
  }
  else if(idleCnt == g_stack.batteryCount)
  {
    strcpy(g_stack.baseState, "Idle");
  }
  else
  {
    strcpy(g_stack.baseState, "Balance");
  }

  return true;
}

void prepareJsonOutput(char* pBuff, int buffSize)
{
  memset(pBuff, 0, buffSize);
  snprintf(pBuff, buffSize-1, "{\"soc\": %d, \"temp\": %d, \"currentDC\": %ld, \"avgVoltage\": %ld, \"baseState\": \"%s\", \"batteryCount\": %d, \"powerDC\": %ld, \"estPowerAC\": %ld, \"isNormal\": %s}", g_stack.soc,
                                                                                                                                                                                                            g_stack.temp,
                                                                                                                                                                                                            g_stack.currentDC,
                                                                                                                                                                                                            g_stack.avgVoltage,
                                                                                                                                                                                                            g_stack.baseState,
                                                                                                                                                                                                            g_stack.batteryCount,
                                                                                                                                                                                                            g_stack.getPowerDC(),
                                                                                                                                                                                                            g_stack.getEstPowerAc(),
                                                                                                                                                                                                            g_stack.isNormal() ? "true" : "false");
}

void loop() {
#ifdef ENABLE_MQTT
  mqttLoop();
#endif

  ArduinoOTA.handle();
  server.handleClient();
  timer.run();

  //if there are bytes availbe on serial here - it's unexpected
  //when we send a command to battery, we read whole response
  //if we get anything here anyways - we will log it
  int bytesAv = Serial.available();
  if(bytesAv > 0)
  {
    if(bytesAv > 63)
    {
      bytesAv = 63;
    }

    char buff[64+4] = "RCV:";
    if(Serial.readBytes(buff+4, bytesAv) > 0)
    {
      digitalWrite(LED_BUILTIN, LOW);
      delay(5);
      digitalWrite(LED_BUILTIN, HIGH);//high is off

      Log(buff);
    }
  }
}

#ifdef ENABLE_MQTT
#define ABS_DIFF(a, b) (a > b ? a-b : b-a)
void mqtt_publish_f(const char* topic, float newValue, float oldValue, float minDiff, bool force)
{
  char szTmp[16] = "";
  snprintf(szTmp, 15, "%.2f", newValue);
  if(force || ABS_DIFF(newValue, oldValue) > minDiff)
  {
    mqttClient.publish(topic, szTmp, false);
  }
}

void mqtt_publish_i(const char* topic, int newValue, int oldValue, int minDiff, bool force)
{
  char szTmp[16] = "";
  snprintf(szTmp, 15, "%d", newValue);
  if(force || ABS_DIFF(newValue, oldValue) > minDiff)
  {
    mqttClient.publish(topic, szTmp, false);
  }
}

void mqtt_publish_s(const char* topic, const char* newValue, const char* oldValue, bool force)
{
  if(force || strcmp(newValue, oldValue) != 0)
  {
    mqttClient.publish(topic, newValue, false);
  }
}

void pushBatteryDataToMqtt(const batteryStack& lastSentData, bool forceUpdate /* if true - we will send all data regardless if it's the same */)
{
  mqtt_publish_f(MQTT_TOPIC_ROOT "soc",          g_stack.soc,                lastSentData.soc,                0, forceUpdate);
  mqtt_publish_f(MQTT_TOPIC_ROOT "temp",         (float)g_stack.temp/1000.0, (float)lastSentData.temp/1000.0, 0, forceUpdate);
  mqtt_publish_i(MQTT_TOPIC_ROOT "estPowerAC",   g_stack.getEstPowerAc(),    lastSentData.getEstPowerAc(),   10, forceUpdate);
  mqtt_publish_i(MQTT_TOPIC_ROOT "battery_count",g_stack.batteryCount,       lastSentData.batteryCount,       0, forceUpdate);
  mqtt_publish_s(MQTT_TOPIC_ROOT "base_state",   g_stack.baseState,          lastSentData.baseState            , forceUpdate);
  mqtt_publish_i(MQTT_TOPIC_ROOT "is_normal",    g_stack.isNormal() ? 1:0,   lastSentData.isNormal() ? 1:0,   0, forceUpdate);
}

void mqttLoop()
{
  //if we have problems with connecting to mqtt server, we will attempt to re-estabish connection each 1minute (not more than that)
  static unsigned long g_lastConnectionAttempt = 0;

  //first: let's make sure we are connected to mqtt
  const char* topicLastWill = MQTT_TOPIC_ROOT "availability";
  if (!mqttClient.connected() && (g_lastConnectionAttempt == 0 || os_getCurrentTimeSec() - g_lastConnectionAttempt > 60)) {
    if(mqttClient.connect("GarageBattery", MQTT_USER, MQTT_PASSWORD, topicLastWill, 1, true, "offline"))
    {
      Log("Connected to MQTT server: " MQTT_SERVER);
      mqttClient.publish(topicLastWill, "online", true);
    }
    else
    {
      Log("Failed to connect to MQTT server.");
    }

    g_lastConnectionAttempt = os_getCurrentTimeSec();
  }

  //next: read data from battery and send via MQTT (but only once per MQTT_PUSH_FREQ_SEC seconds)
  static unsigned long g_lastDataSent = 0;
  if(mqttClient.connected() &&
     os_getCurrentTimeSec() - g_lastDataSent > MQTT_PUSH_FREQ_SEC &&
     sendCommandAndReadSerialResponse("pwr") == true)
  {
    static batteryStack lastSentData; //this is the last state we sent to MQTT, used to prevent sending the same data over and over again
    static unsigned int callCnt = 0;

    parsePwrResponse(g_szRecvBuff);

    bool forceUpdate = (callCnt % 20 == 0); //push all the data every 20th call
    pushBatteryDataToMqtt(lastSentData, forceUpdate);

    callCnt++;
    g_lastDataSent = os_getCurrentTimeSec();
    memcpy(&lastSentData, &g_stack, sizeof(batteryStack));
  }

  mqttClient.loop();
}

#endif //ENABLE_MQTT
`

Rustimation, 2024-11-15:
As promised: here's the updated ino filte that reflects the new structure of the _pwr_ response

alternatively see [fork of PylontechMonitor](https://www.rustimation.eu/index.php/solar-pylontech-akku-ueber-konsole-aufwecken/)  (German language)

[PylontechMonitoring_newPwrStructure.zip](https://github.com/user-attachments/files/17773625/PylontechMonitoring_newPwrStructure.zip)

Closed 2024-11-15.

Thread 33 (2025-02-18):

RS232 console port stopped working

killamilla0815, 2025-02-18:
Hello

I am running this projekt for around 1 1/2 years on a single US2000C battery and never had any issues with it, everything worked like a charm.

Due to missing home assistant integration I thought let's try another fork based on this projekt, which adds some basic HA auto discovery features (
https://github.com/hidaba/PylontechMonitoring).

After flashing this projekt, it worked right from the start and everything seemed fine. Then, after some minor time zone related change in the config file and flashing the projekt, the battery stopped communicating via RS232.  Web-interface is accessible, but no reply from the battery.
"json.out" web-query just provides 0 values. Same result with another ESP chip, so must be related to the battery.

Therefore I thought, lets hook it up to the PC via a direct RS232-RJ45 cable. Same result there, battery doesn't respond, checked via several terminal tools (send start sequence first with low speed and switch to 115200 then, but no respond).
Finally I tried the Pylontech tool "BatteryView" and had the same result:  tool won't connect to the battery but gives "time-out" error message.

I'm struggling to understand how this could happen. Are there any known cases of physical damage of the internal console port so that it stops communicating ? Anyone here who experienced a similar problem maybe ?

Thanks.

schurgan, 2025-06-09:
Hello, I have the same problem. Everything worked perfectly for two years. It started two months ago with the first module. The connection via console doesn't work, neither with Battery Monitor nor with BatteryView. Then I tried swapping the memory modules with each other, thus trying to swap three modules. All three memory modules lost the connection after I plugged in the Battery Monitor connector. That's why I'm assuming something is wrong here. The last option I have to find out something is that I can use BatteryView to access the defective ones via the last functioning memory module, since the connection via the port connections still seems to work.

Thread 34 (2025-03-03):

Unknown Command

Pyinthesky99, 2025-03-03:
Many thanks to all who have contributed to this excellent project.

I have only just assembled the hardware and loaded the code to a D1 Mini. When I browse into it I get ..

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

So all good so far. If I then try the getpwr command, It returns

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

as if inserting a $ to the front of the command <edit> although "Help" works OK

Any ideas?

I am a complete newbie to Arduino, but have managed to get a Home Assistant chatting to my Solis Inverter which gives basic battery information but this project adds a lot more.

Apologies if it is inappropriate asking a stupid question here, if it is please point me in the correct direction, forum,etc.

Pyinthesky99, 2025-03-03:
Update...

If I use the command box, the result is as above, if I use the links below the command box, I get valid returns (except the time is off)

Pyinthesky99, 2025-03-04:
Working this morning, how odd

Closed 2025-03-04.
