irekzielinski/Pylontech-Battery-Monitoring/(commit log)

2019-08-26 added schematics
2020-07-13 fixed minor issue with MQTT updates beign sent too frequently
    [PylontechMonitoring.ino]
2020-07-14 added detection of battery Balancing
2021-12-16 added information about US2000C battery
2021-12-19 also tested on US3000C battery
